charbel-j-estephan/Fm_Stereo_Encoder_Decoder/Decoder/preview_bottom.png

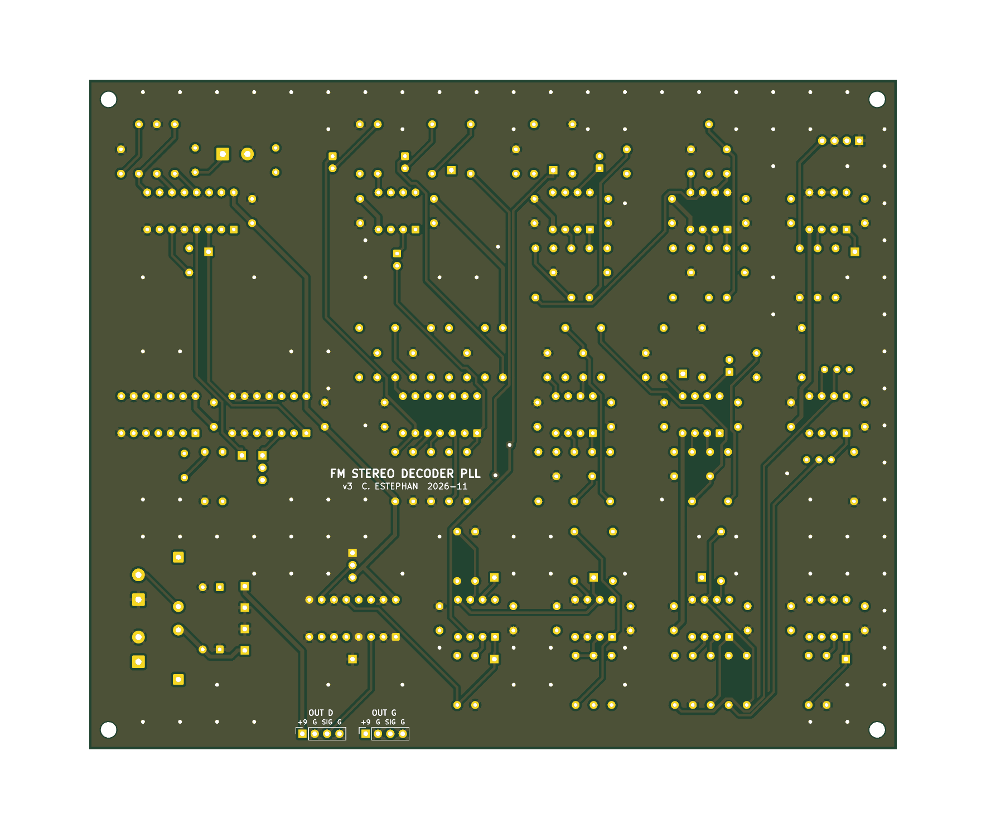
Decoder/preview_bottom.png
