charbel-j-estephan/Fm_Stereo_Encoder_Decoder/Decoder/preview_top.png

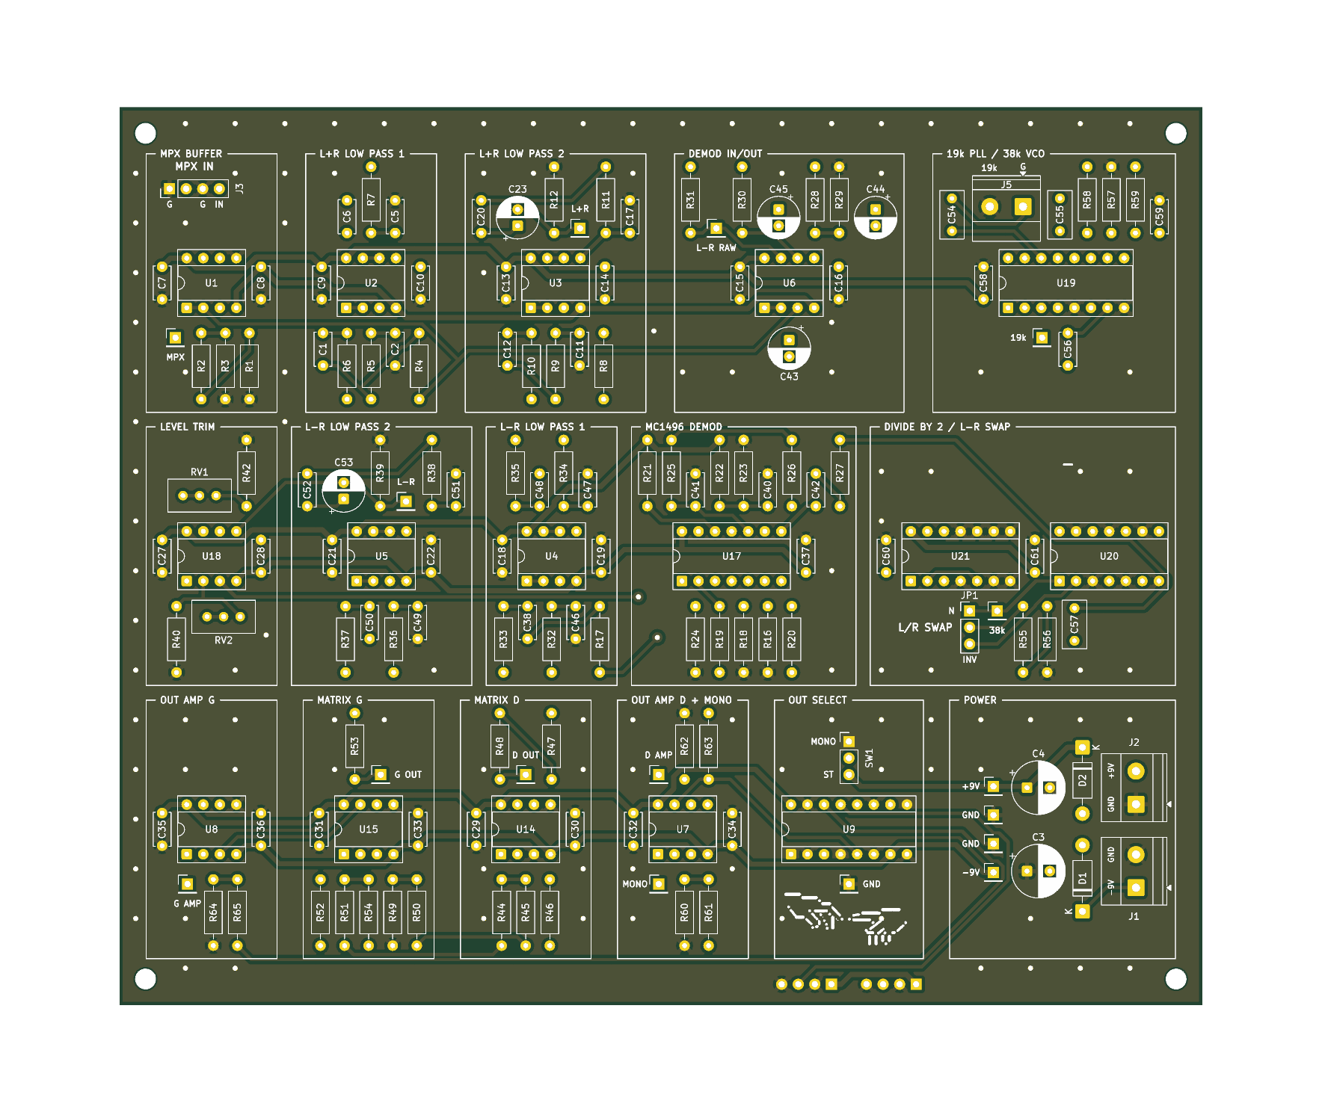
Decoder/preview_top.png
