charbel-j-estephan/Fm_Stereo_Encoder_Decoder/Encoder/FM_Encoder_Buy_List.xlsx

Sheet: Buy list
Group | Part | Refs | Qty needed | Qty to buy | Unit price USD | Line total USD | EKT item | Link | Notes
ICs | CD4046 PLL | U11 | 1 | 2 | $0.60 |  | 149 | https://ekt1.com/en/item/149
ICs | CD4013 dual D flip flop | U12 | 1 | 2 | $0.50 |  | 136 | https://ekt1.com/en/item/136
ICs | CD4069 hex inverter | U13 | 1 | 2 | $0.50 |  | 157 | https://ekt1.com/en/item/157
ICs | TL072 dual op amp | U1 U3 U4 U5 U6 U8 | 6 | 7 | $0.60 |  | 1492 | https://ekt1.com/en/item/1492
ICs | NE5532P dual op amp | U2 U10 | 2 | 3 | $0.50 |  | 4489 | https://ekt1.com/en/item/4489
ICs | MC1496 balanced modulator | U9 | 1 | 2 | $1.75 |  | 6175 | https://ekt1.com/en/item/6175
Sockets | DIP 8 socket | U1 U2 U3 U4 U5 U6 U8 U10 | 8 | 9 | $0.08 |  | 1973 | https://ekt1.com/en/item/1973
Sockets | DIP 14 socket | U9 U12 U13 | 3 | 4 | $0.10 |  | 1975 | https://ekt1.com/en/item/1975
Sockets | DIP 16 socket | U11 | 1 | 2 | $0.10 |  | 1974 | https://ekt1.com/en/item/1974
Diodes | 1N5819 Schottky | D1 D2 | 2 | 3 | $0.15 |  | 7983 | https://ekt1.com/en/item/7983
Diodes | 1N4148 | D3 D4 D5 D6 | 4 | 6 | $0.05 |  | 2520 | https://ekt1.com/en/item/2520
Resistors | 51R 0.25W | R31 R32 | 2 | 4 | $0.01 |  | 6386 | https://ekt1.com/en/item/6386
Resistors | 1K 0.5W substitute | R29 R35 R37 | 3 | 5 | $0.02 |  | 2435 | https://ekt1.com/en/item/2435 | 0.25W 1K (item 6409) is out of stock
Resistors | 1K5 0.25W | R55 | 1 | 3 | $0.01 |  | 6398 | https://ekt1.com/en/item/6398
Resistors | 1K8 0.25W | R7 R8 | 2 | 4 | $0.01 |  | 6369 | https://ekt1.com/en/item/6369
Resistors | 2K2 0.25W | R42 (and R1 R5 if you accept 2K2) | 1 | 3 | $0.01 |  | 6411 | https://ekt1.com/en/item/6411 | EKT has no 2K4. See next row
Resistors | 2K4 0.25W | R1 R5 | 2 | 0 |  |  |  |  | Not on EKT. Use 2K2 or ask EKT. Check gain change first
Resistors | 3K3 0.25W | R16 R18 | 2 | 4 | $0.01 |  | 6412 | https://ekt1.com/en/item/6412
Resistors | 3K9 0.25W | R34 R36 | 2 | 4 | $0.01 |  | 6413 | https://ekt1.com/en/item/6413
Resistors | 4K7 0.25W | R53 | 1 | 3 | $0.01 |  | 6394 | https://ekt1.com/en/item/6394
Resistors | 6K8 0.25W | R33 | 1 | 3 | $0.01 |  | 6414 | https://ekt1.com/en/item/6414
Resistors | 7K5 0.25W | R41 | 1 | 3 | $0.01 |  | 6418 | https://ekt1.com/en/item/6418
Resistors | 8K2 0.25W | R54 | 1 | 3 | $0.01 |  | 6375 | https://ekt1.com/en/item/6375
Resistors | 10K 0.25W | R2 R3 R9 R10 R11 R12 R38 R52 | 8 | 10 | $0.01 |  | 6410 | https://ekt1.com/en/item/6410
Resistors | 12K 0.25W | R13 R14 R15 R17 R51 | 5 | 7 | $0.01 |  | 6422 | https://ekt1.com/en/item/6422 | R51 sets the VCO range
Resistors | 15K 0.25W | R39 R40 R43 R44 | 4 | 6 | $0.01 |  | 6423 | https://ekt1.com/en/item/6423
Resistors | 100K 0.25W | R4 R6 R19 R20 R21 R22 R23 R24 R25 R26 R27 R28 R30 R45 R48 R49 R50 | 17 | 20 | $0.01 |  | 6425 | https://ekt1.com/en/item/6425
Resistors | 270K 0.25W | R46 | 1 | 3 | $0.01 |  | 6353 | https://ekt1.com/en/item/6353
Resistors | 330K 0.25W | R47 in series with 30K | 1 | 3 | $0.01 |  | 6352 | https://ekt1.com/en/item/6352 | 330K plus 30K makes 360K
Resistors | 30K 0.25W | R47 in series with 330K | 1 | 3 | $0.01 |  | 211576 | https://ekt1.com/en/item/211576 | EKT has no 360K
Capacitors | 100n multilayer ceramic 50V | C7 C8 C9 C10 C13 C14 C15 C16 C18 C19 C21 C22 C27 C28 C29 C30 C37 C38 C39 C40 C41 C42 C43 C44 C48 C50 C51 C52 | 28 | 34 | $0.10 |  | 218477 | https://ekt1.com/en/item/218477
Capacitors | 1n multilayer ceramic 50V | C5 C20 C23 C24 C25 C26 C47 | 7 | 9 | $0.10 |  | 218480 | https://ekt1.com/en/item/218480 | Also use 1 for C6 with 220p
Capacitors | 2.2n ceramic 50V | C17 C32 C34 | 3 | 5 | $0.10 |  | 1965 | https://ekt1.com/en/item/1965
Capacitors | 3.3n ceramic 50V | C35 | 1 | 3 | $0.10 |  | 1966 | https://ekt1.com/en/item/1966
Capacitors | 330p ceramic 50V | C31 C33 | 2 | 4 | $0.10 |  | 1950 | https://ekt1.com/en/item/1950
Capacitors | 220p ceramic 50V | C36 and C6 in parallel with 1n | 1 | 3 | $0.10 |  | 1949 | https://ekt1.com/en/item/1949 | EKT has no 1.2n. 1n plus 220p makes 1.22n for C6
Capacitors | 100p ceramic 50V | C11 C12 | 2 | 4 | $0.10 |  | 1948 | https://ekt1.com/en/item/1948 | Footprint is small. Multilayer 100p (item 218478) may fit better
Capacitors | 1u film 105 100V | C1 C2 C45 C46 C49 | 5 | 7 | $0.20 |  | 2182 | https://ekt1.com/en/item/2182 | Measure first. Footprint is 7.2 by 3.5 mm, 5 mm pitch
Capacitors | 22u 25V electrolytic | C3 C4 | 2 | 3 | $0.10 |  | 2103 | https://ekt1.com/en/item/2103 | 13x5 mm part. Footprint is 8 mm wide, 3.5 mm pitch
Connectors | Screw terminal 5.08 mm 2 pin | J1 J2 J5 | 3 | 4 | $0.08 |  | 6530 | https://ekt1.com/en/item/6530 | J5 is the 19 kHz input
Connectors | Female header strip 10x1 | J3 J4 (2 pieces of 4 pins) | 2 | 2 | $0.30 |  | 8332 | https://ekt1.com/en/item/8332 | Skip if you use the jack modules
Connectors | Male header strip 40x1 | JP1 (3 pins) and 35 test points (TP) as single pins | 38 | 2 | $0.20 |  | 8331 | https://ekt1.com/en/item/8331 | 38 pins in total. Buy 2 strips so you have spares. Dynamic Solutions sells the same strip at 0.20
Connectors | BNC female screw junction | J5 input (one per board) | 1 | 4 | $0.60 |  | 426959 | https://ekt1.com/en/item/426959 | Center screw to J5 pin 1, shield screw to J5 pin 2. Ask EKT for 4 with Ask for quantity
Connectors | Audio Module Jack 3.5mm | J3 J4 modules | 4 | 5 | $0.87 |  |  |  | Not found on ekt1.com. Wakilni link in the Notes sheet. Ask EKT
Connectors | Jumper shunt 2.54 mm 2 pin | JP1 | 1 | 2 | $0.10 |  | 214104 | https://ekt1.com/en/item/214104 | Found on ekt1.com
 |  |  |  |  | Total before VAT

Sheet: Notes
Prices come from ekt1.com in October 2026 and exclude VAT.
Yellow rows are not sold on ekt1.com. Ask EKT or use the substitute.
Wakilni jack module link https://shop.wakilni.com/product/audio-module-jack-3-5mm-connector/ at $0.87. The page says EKT Katrangi Bros sells it.
Quantities needed come from the Encoder_gen schematic netlist. Buy quantities add spares.
J5 is a 2 pin screw terminal. Glue the BNC screw junction to a base plate or bracket and wire it to J5 with short twisted wires.
Test points are single 2.54 mm male header pins broken off the strip. The board has four 3.2 mm corner holes for M3 screws.
Check the 1u film, 22u electrolytic and 100p sizes against the board footprints before you pay.
