charbel-j-estephan/Fm_Stereo_Encoder_Decoder/Decoder/Receiver schematic.pdf

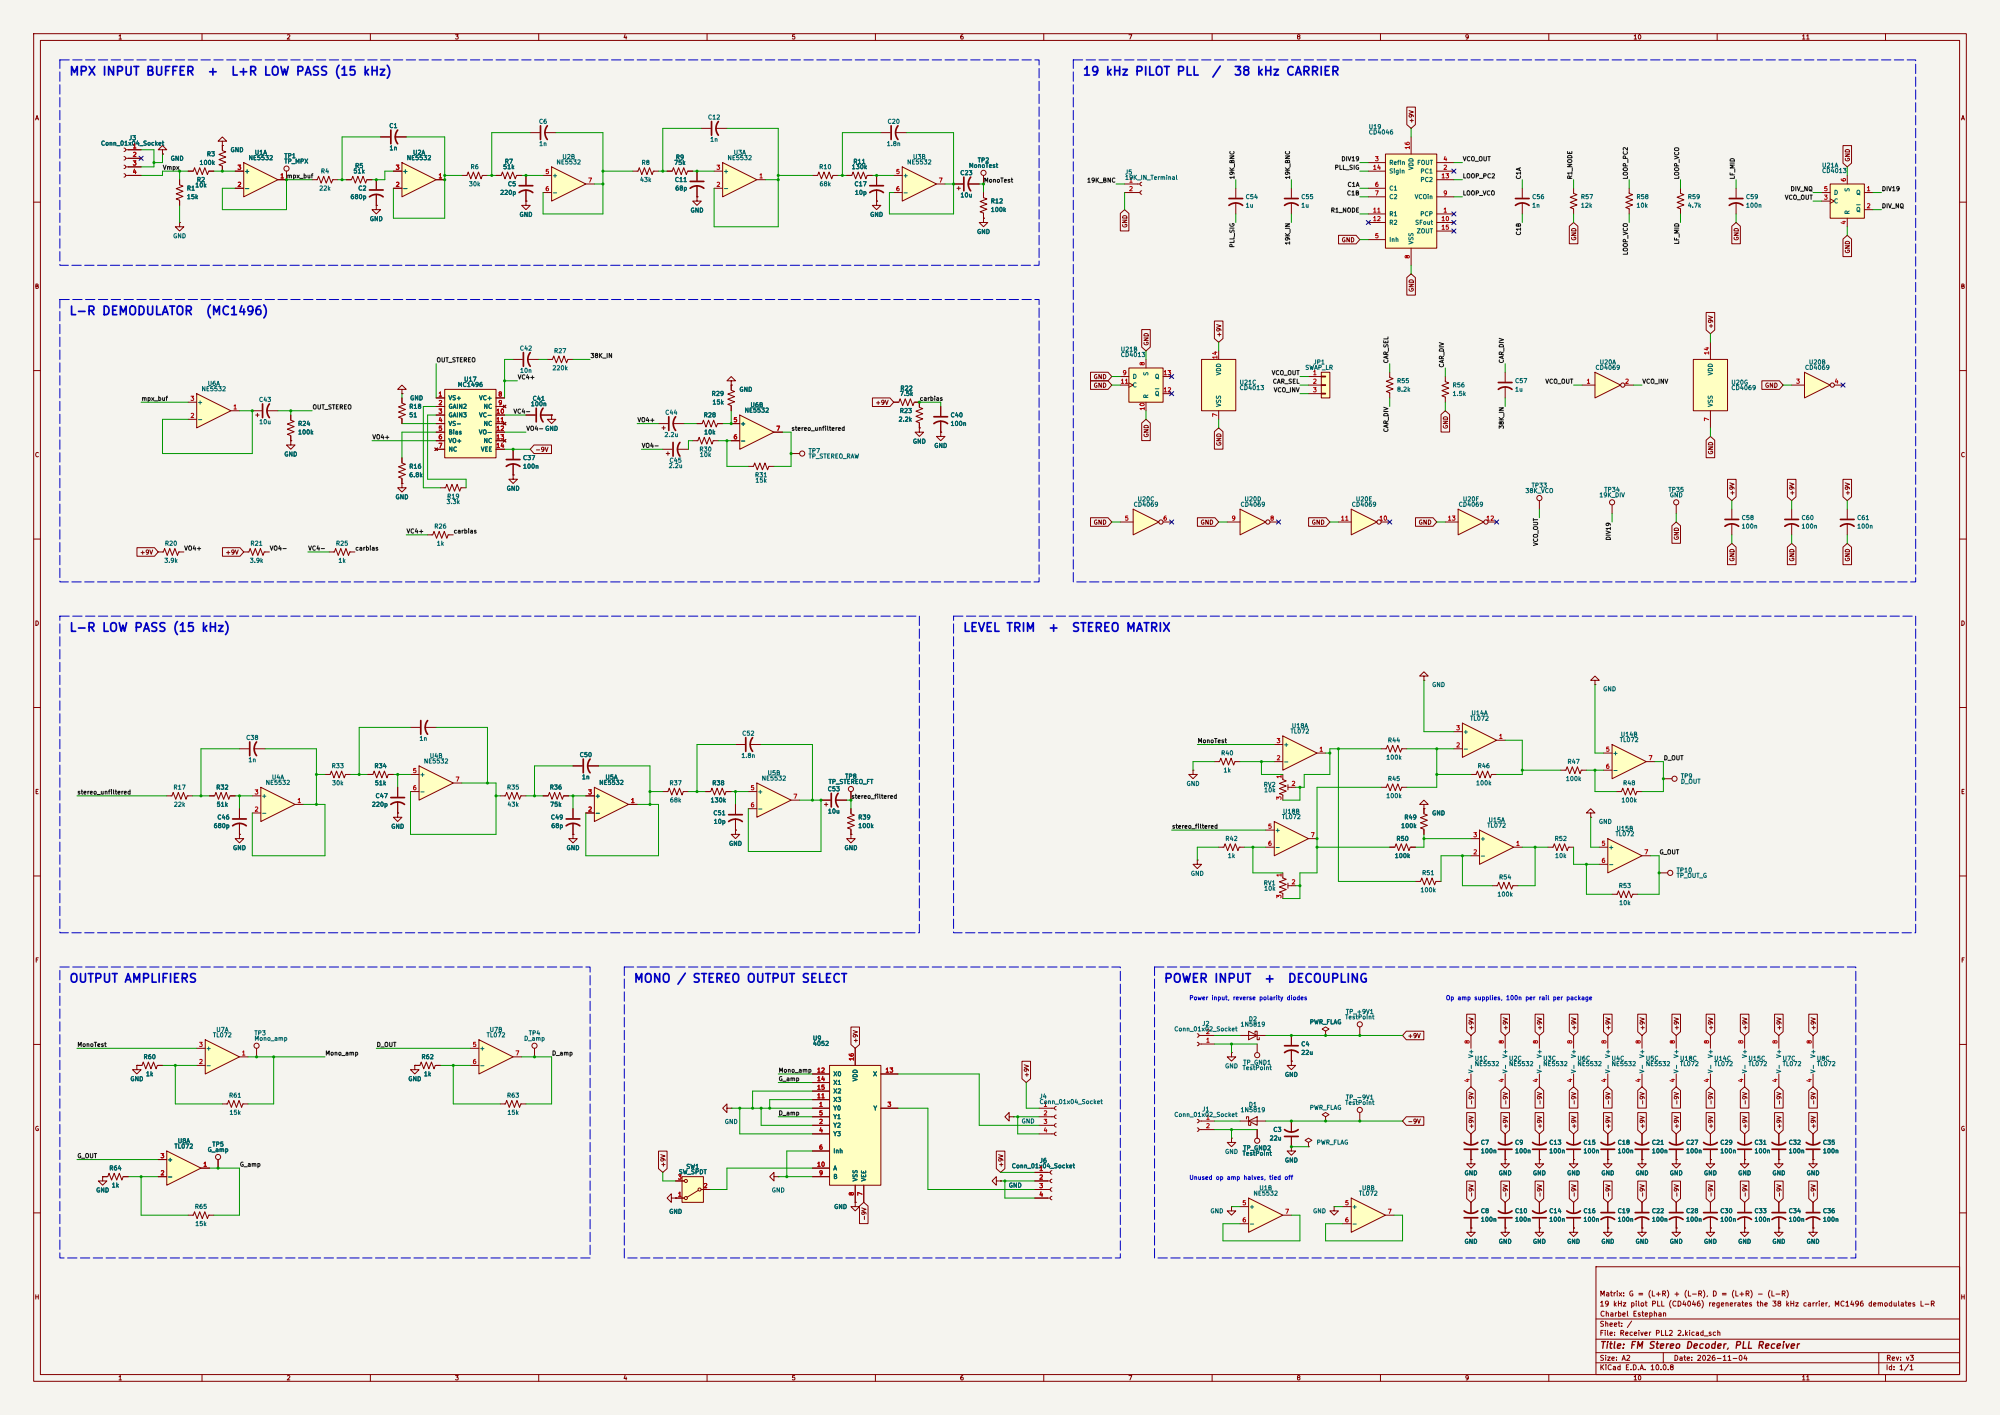
[picture p4: page 1]

Power input, reverse polarity diodes L-R LOW PASS (15 kHz)

LEVEL TRIM + STEREO MATRIX

MONO / STEREO OUTPUT SELECT

Op amp supplies, 100n per rail per package

Matrix: G = (L+R) + (L-R), D = (L+R) - (L-R)
19 kHz pilot PLL (CD4046) regenerates the 38 kHz carrier, MC1496 demodulates L-R
Charbel Estephan
Sheet: /
File: Receiver PLL2 2.kicad_sch
Title: FM Stereo Decoder, PLL Receiver

Size: A2 | Rev: v3
KiCad E.D.A. 10.0.8 | Id: 1/1
