charbel-j-estephan/Fm_Stereo_Encoder_Decoder/Encoder/Encoder_Schematic_color.pdf

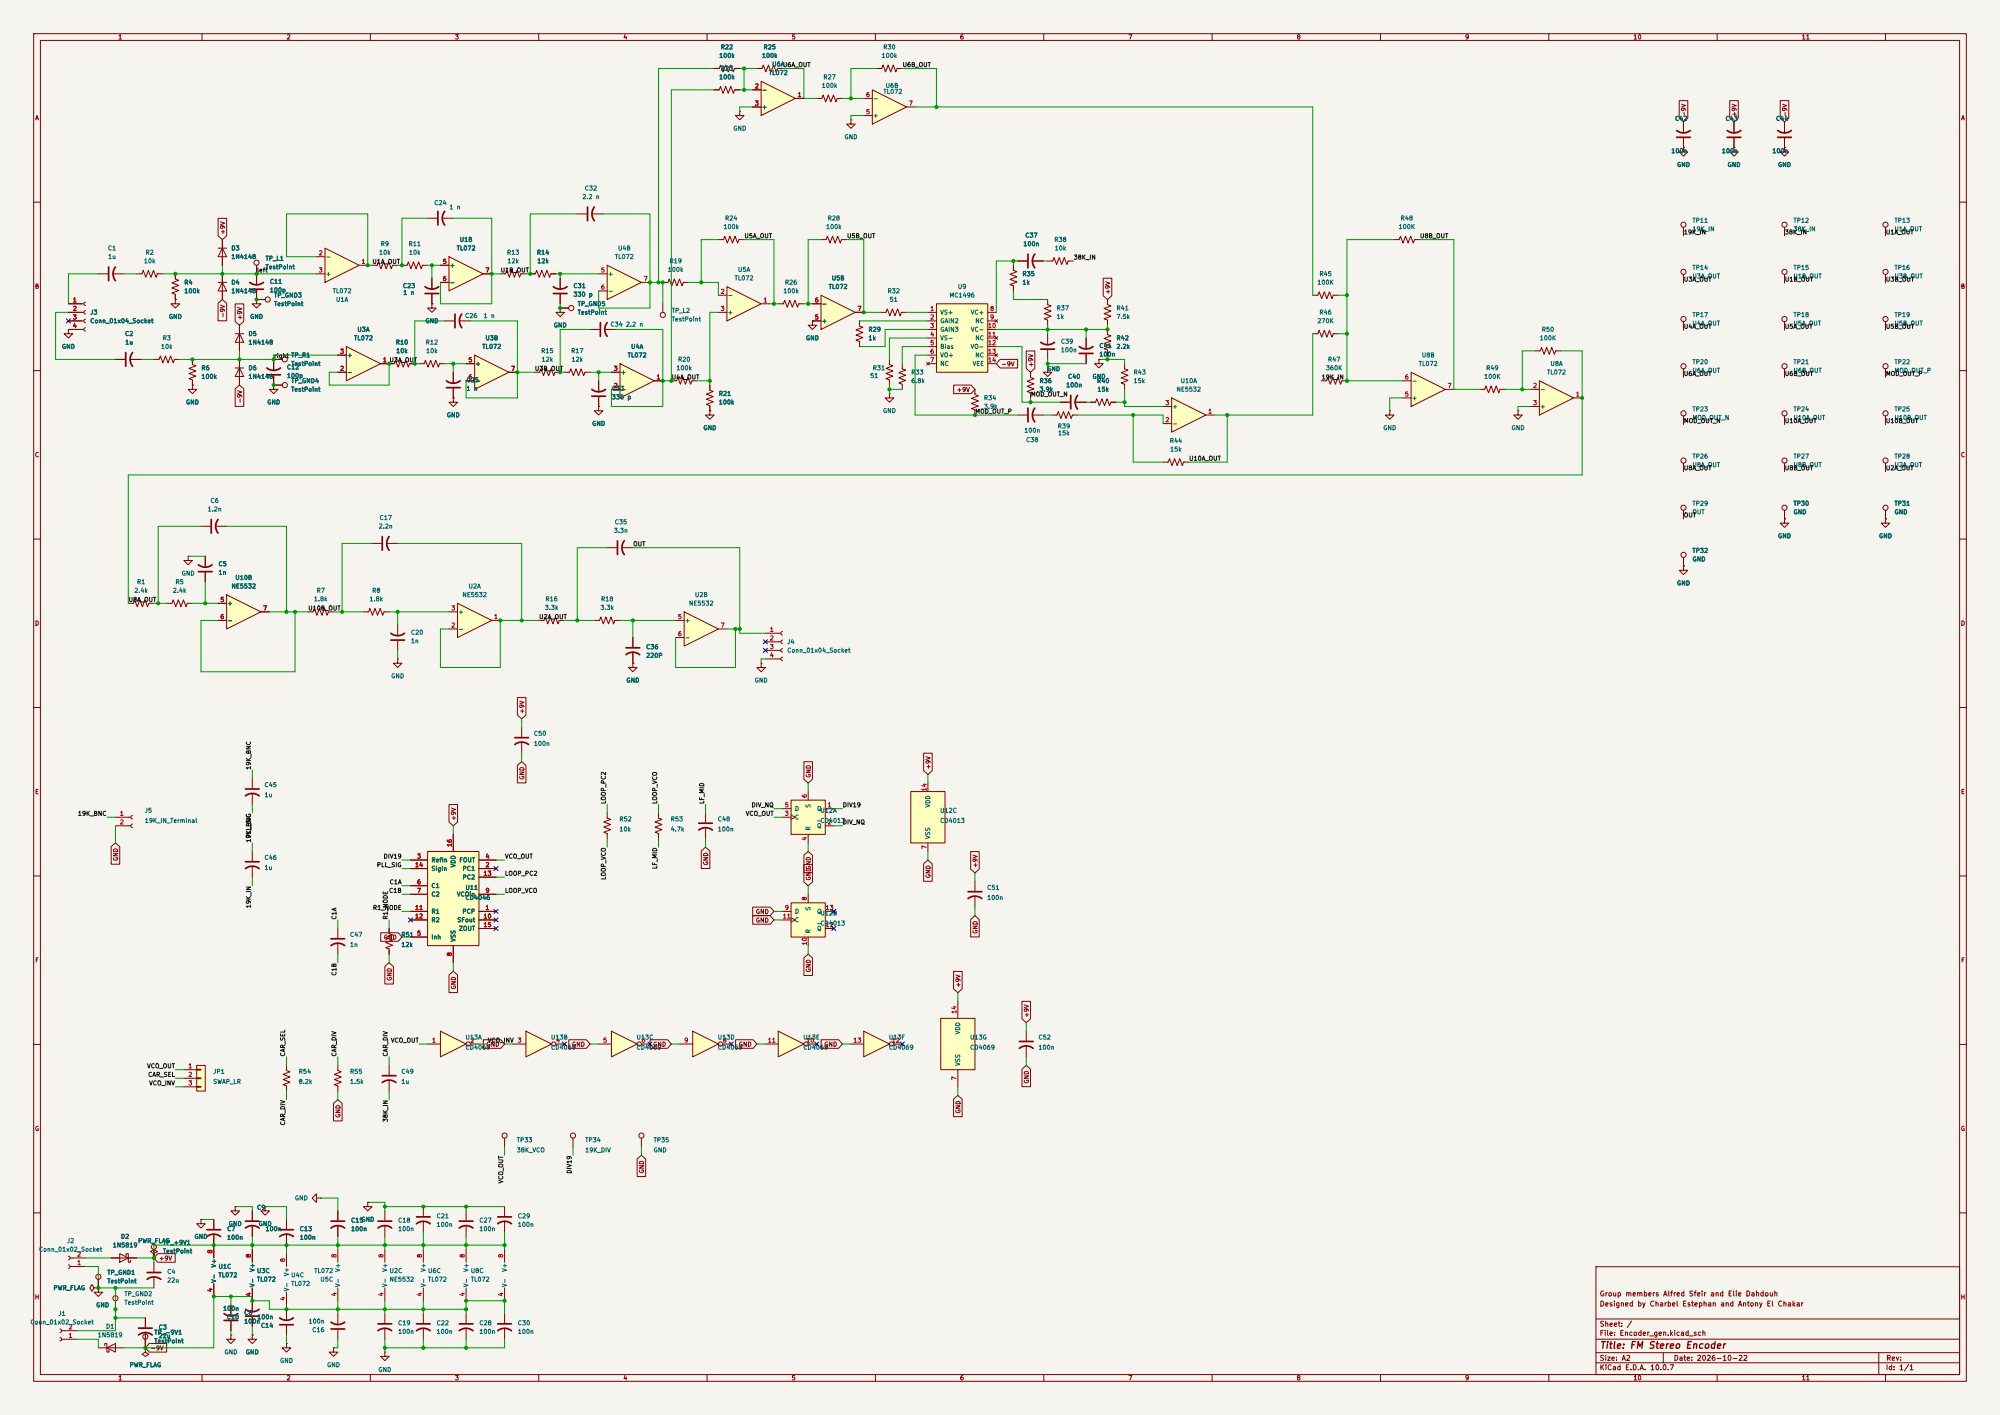
[picture p5: page 1]

Group members Alfred Sfeir and Elie Dahdouh
Designed by Charbel Estephan and Antony El Chakar

Sheet: /
File: Encoder_gen.kicad_sch
Title: FM Stereo Encoder

Size: A2 | Rev:
KiCad E.D.A. 10.0.7 | Id: 1/1
