charbel-j-estephan/Fm_Stereo_Encoder_Decoder/Encoder/Encoder_PCB_top_1to1_color.pdf

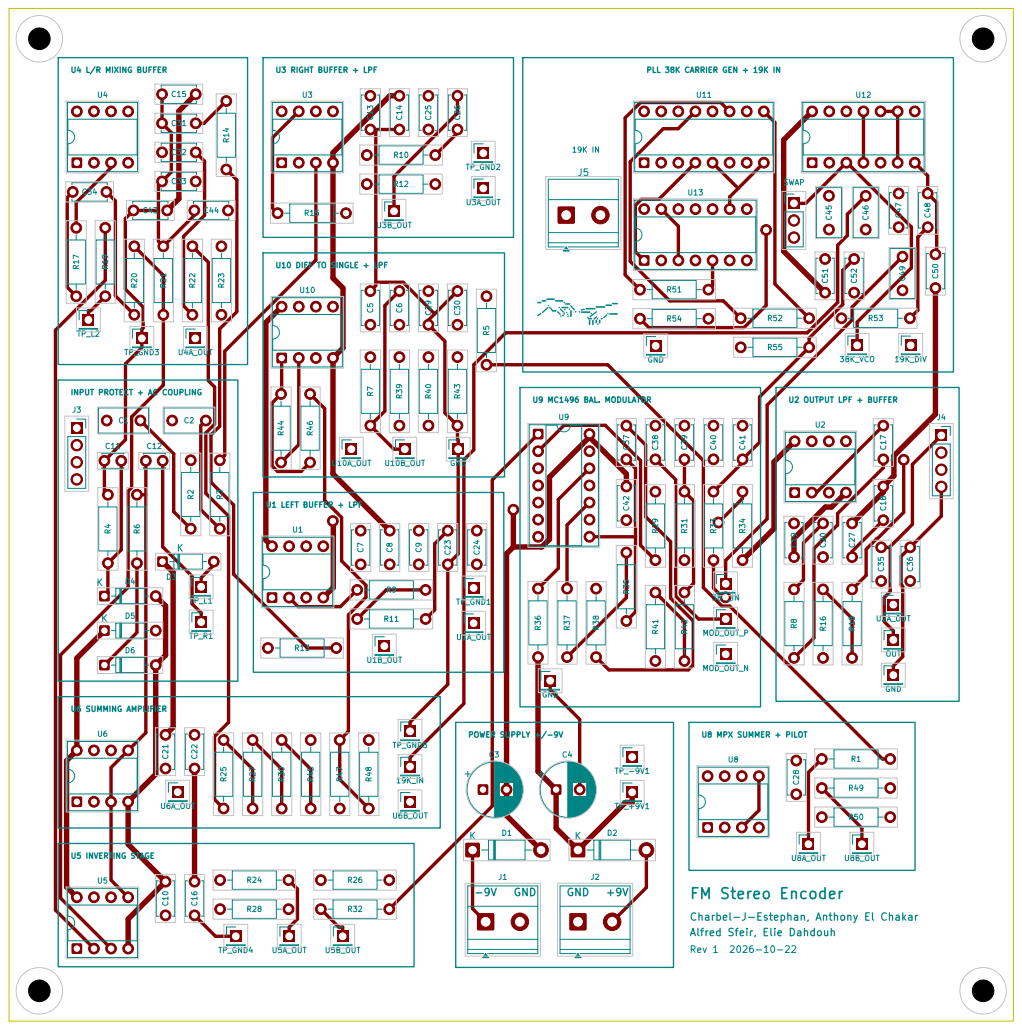
[picture p6: page 1]

PLL 38K CARRIER GEN + 19K IN
