charbel-j-estephan/Fm_Stereo_Encoder_Decoder/Decoder/Receiver.kicad_pcb

## KiCad design Decoder/Receiver.kicad_pcb (2026-11-05)

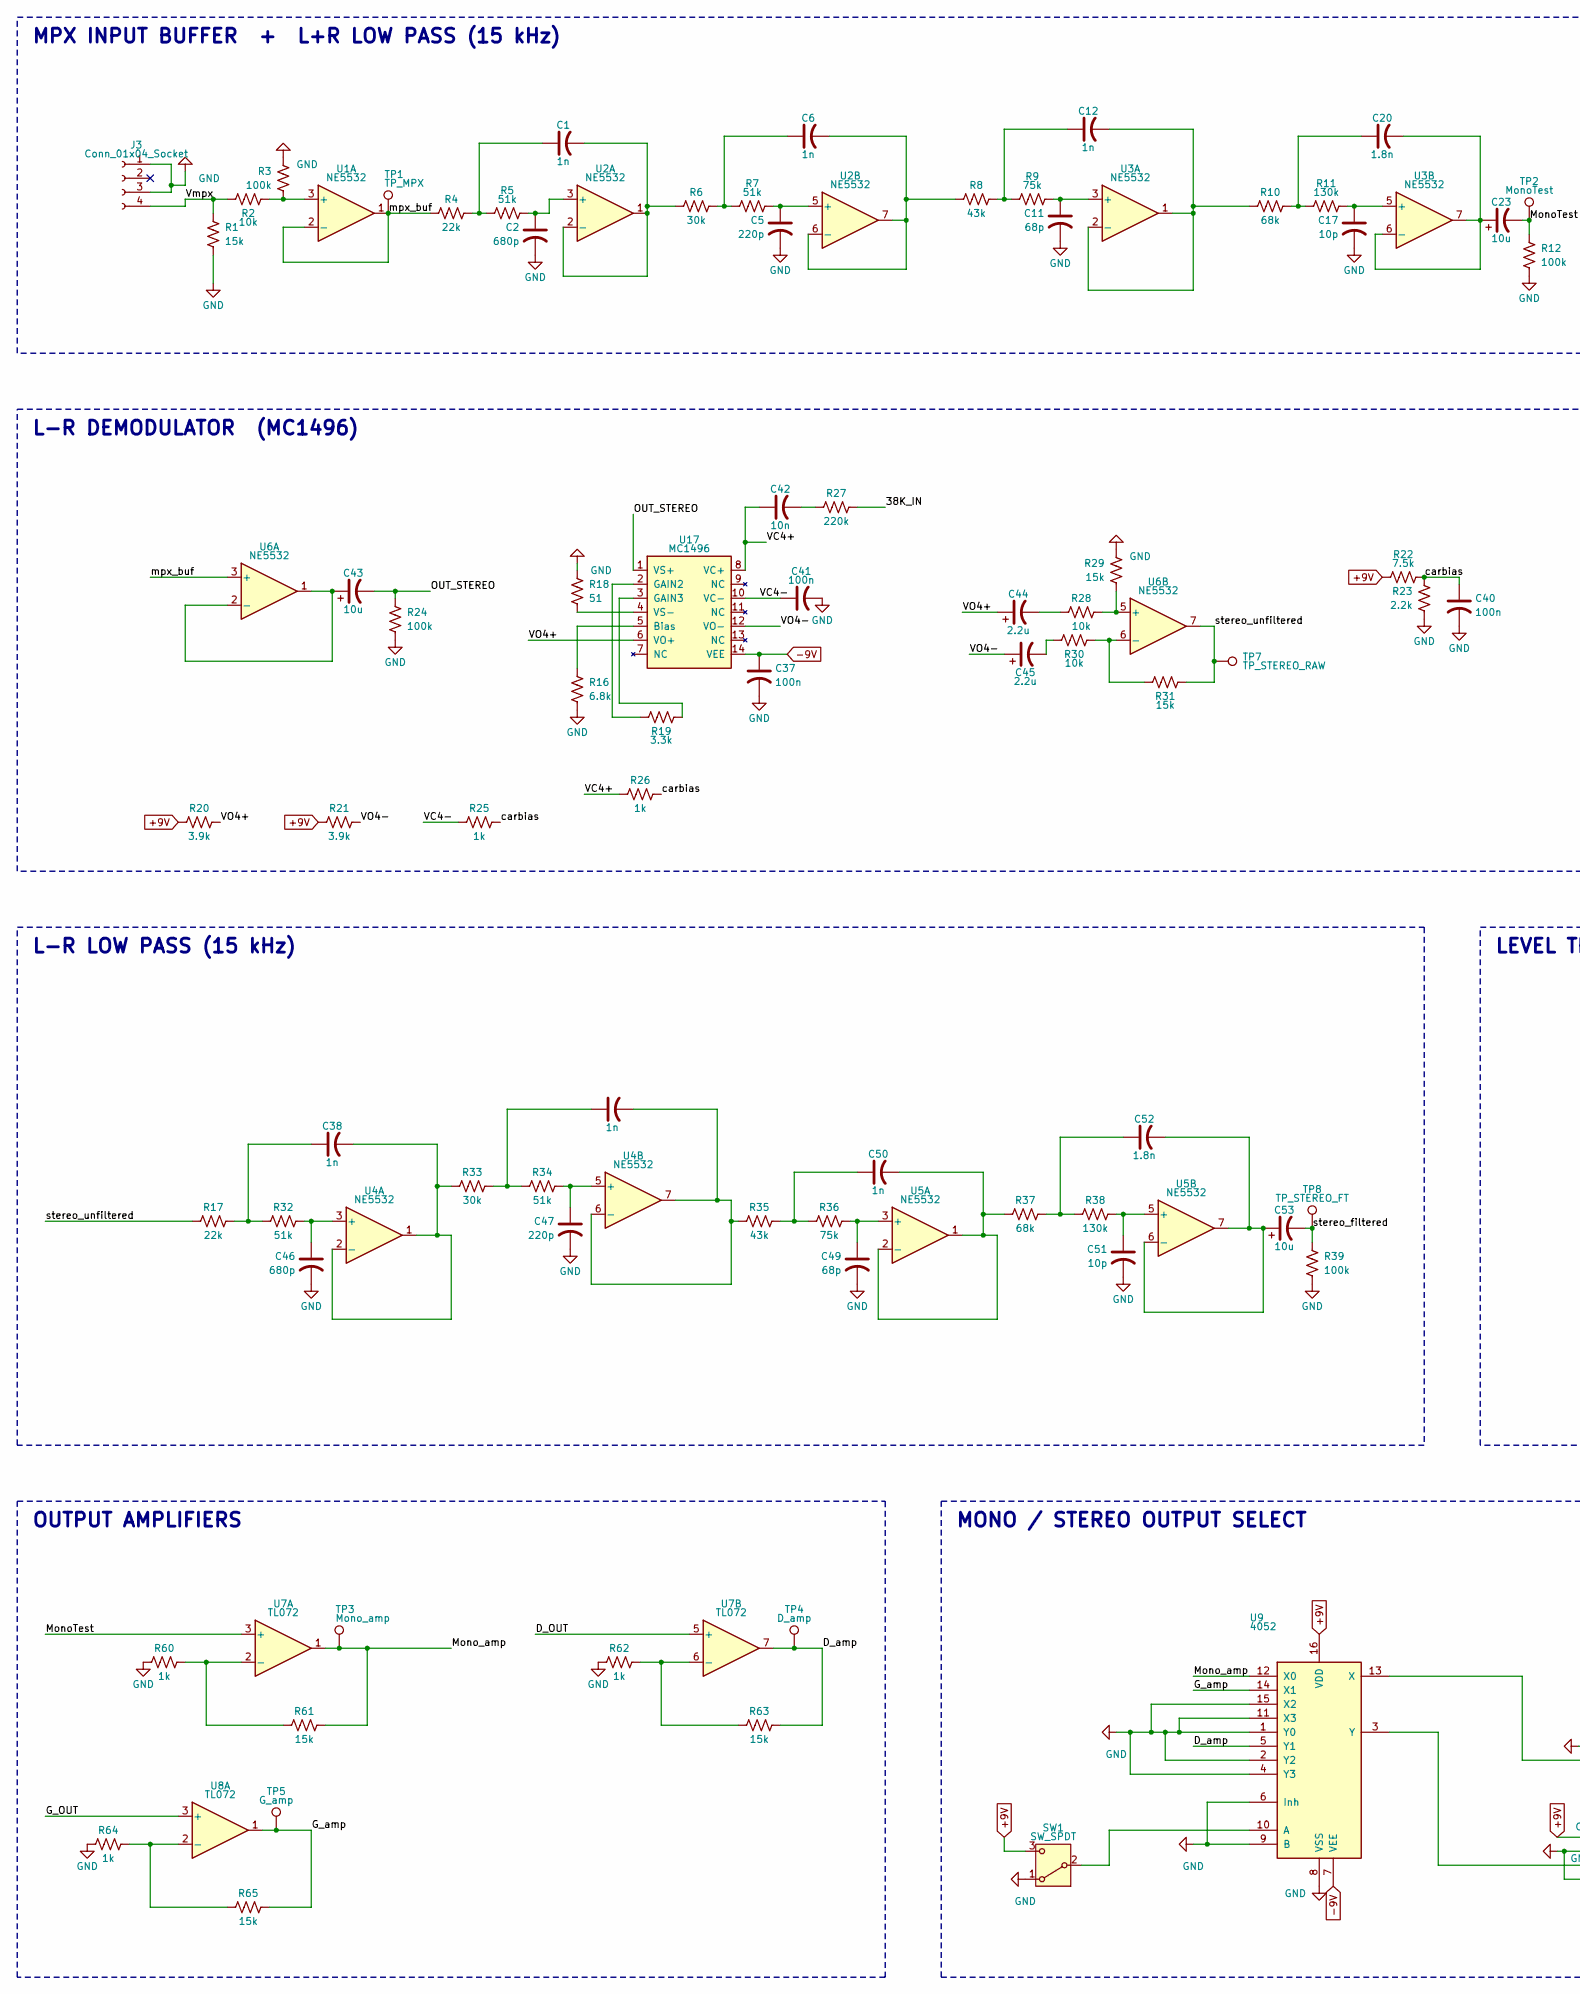
[picture p7: schematic Receiver.kicad_sch, FM Stereo Decoder, PLL Receiver, part in row 1, column 1]

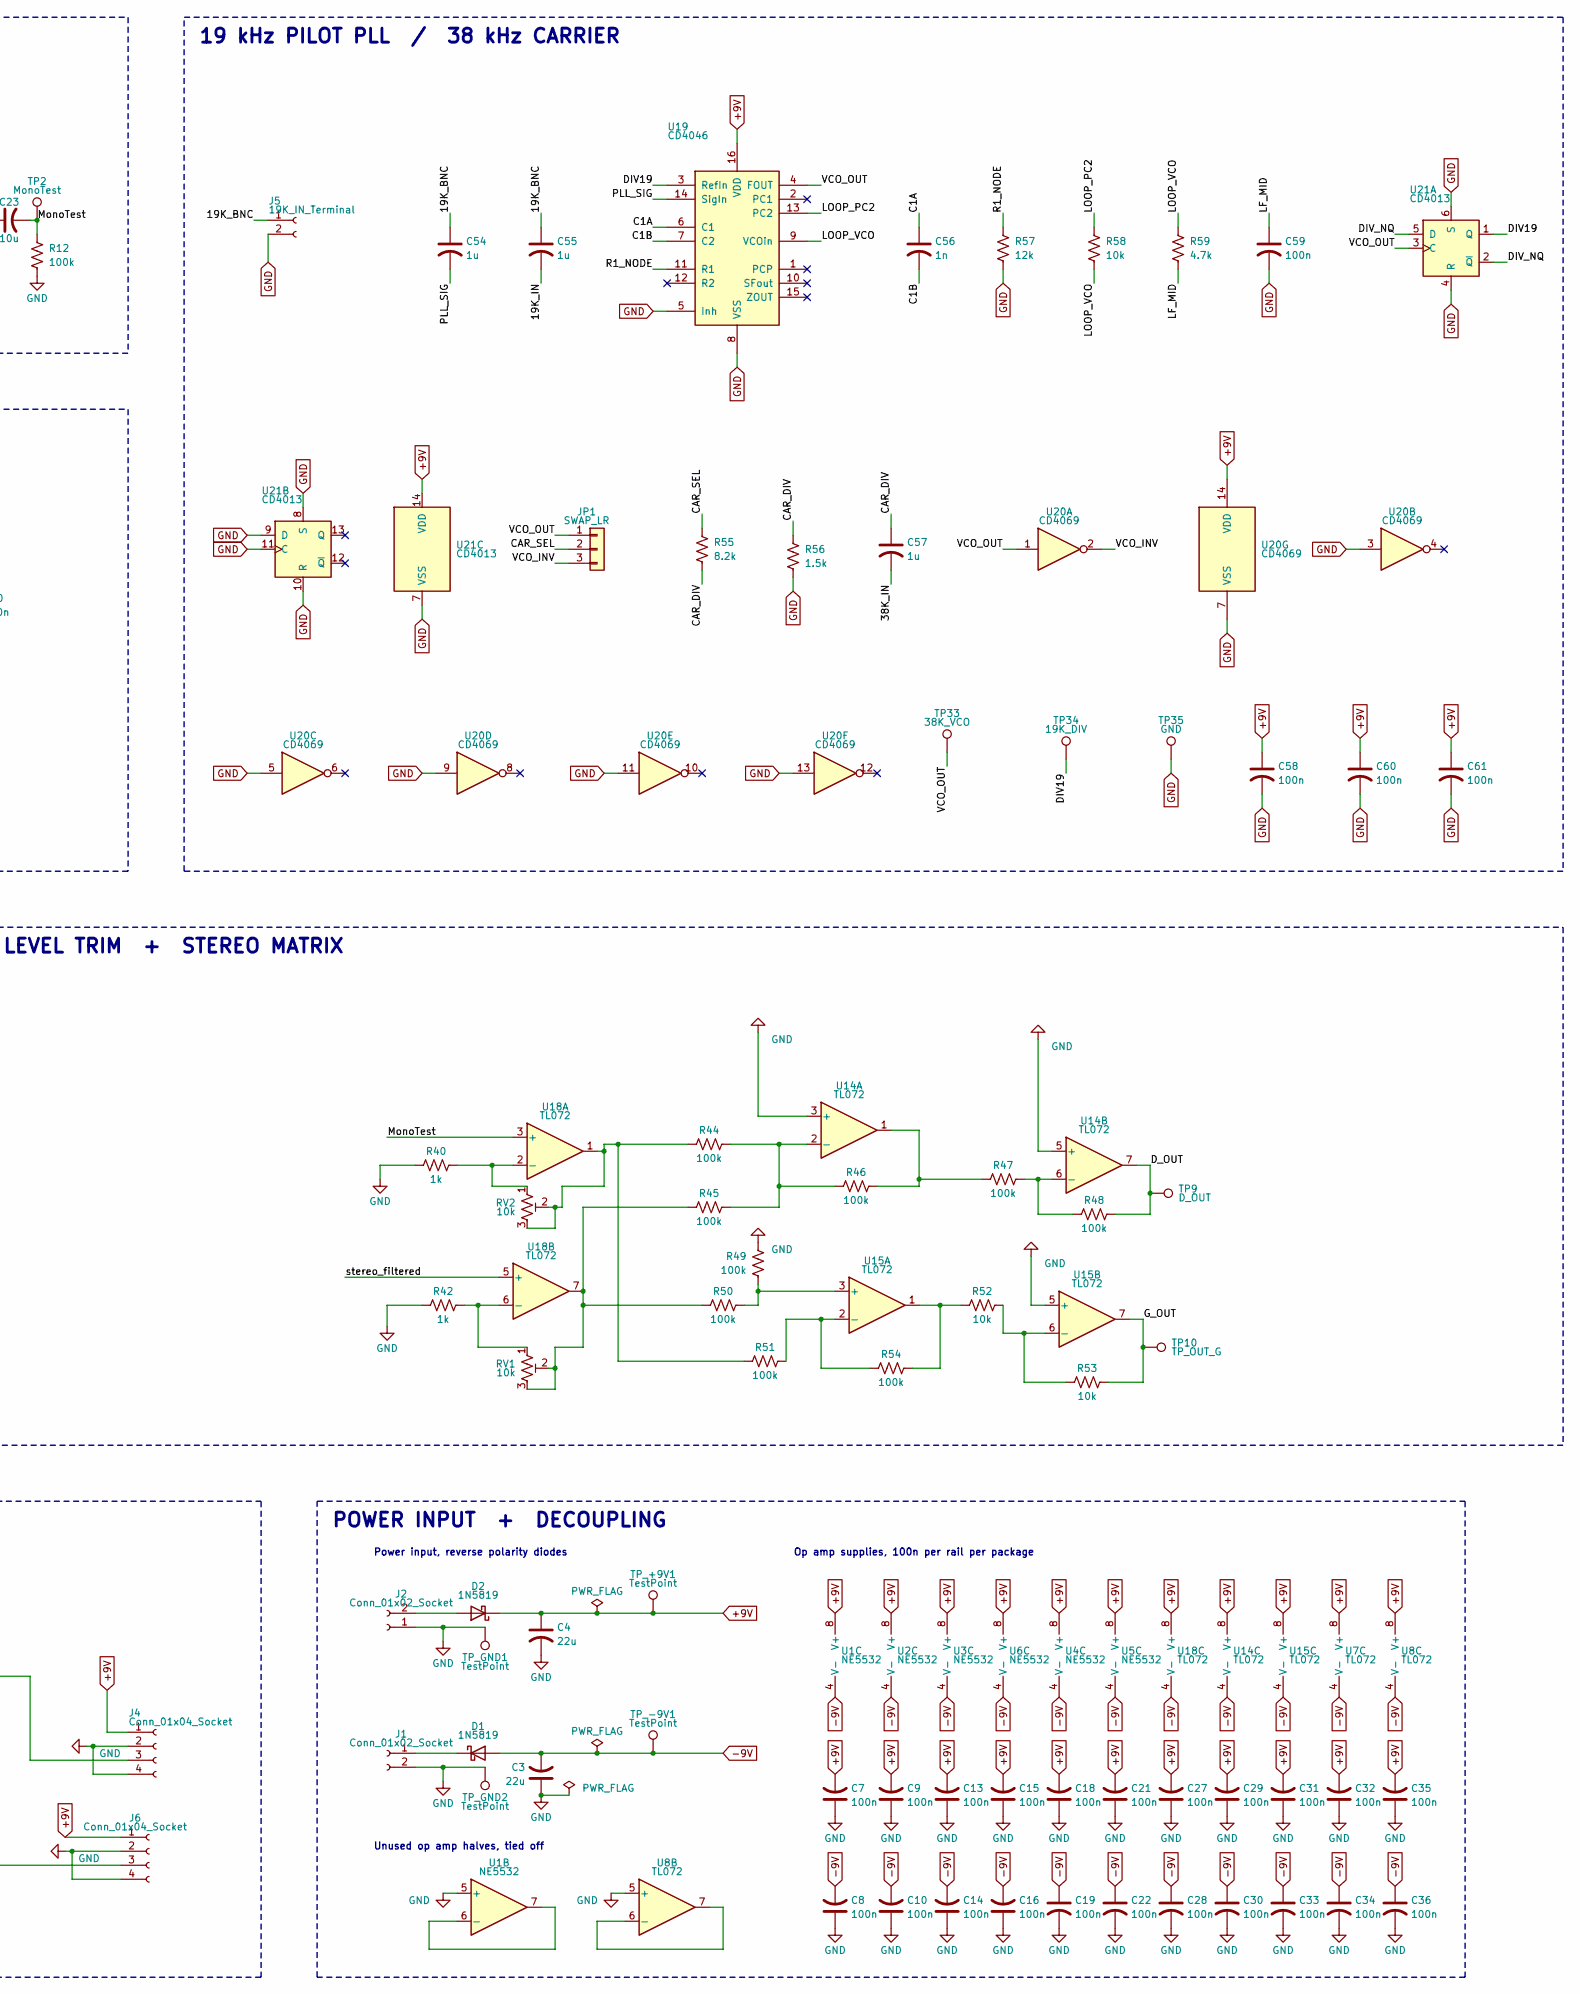
[picture p8: schematic Receiver.kicad_sch, FM Stereo Decoder, PLL Receiver, part in row 1, column 2]

Parts:
C1, C6, C12, C38, C48, C50, C56: 1n; C_Disc_D5.0mm_W2.5mm_P5.00mm
C2, C46: 680p; C_Disc_D5.0mm_W2.5mm_P5.00mm
C3, C4: 22u; CP_Radial_D8.0mm_P3.50mm
C5, C47: 220p; C_Disc_D5.0mm_W2.5mm_P5.00mm
C7, C8, C9, C10, C13, C14, C15, C16, C18, C19, C21, C22, C27, C28, C29, C30, C31, C32, C33, C34, C35, C36, C37, C40, C41, C58, C59, C60, C61: 100n; C_Disc_D5.0mm_W2.5mm_P5.00mm
C11, C49: 68p; C_Disc_D5.0mm_W2.5mm_P5.00mm
C17, C51: 10p; C_Disc_D5.0mm_W2.5mm_P5.00mm
C20, C52: 1.8n; C_Disc_D5.0mm_W2.5mm_P5.00mm
C23, C43, C53: 10u; CP_Radial_D6.3mm_P2.50mm
C42: 10n; C_Disc_D5.0mm_W2.5mm_P5.00mm
C44, C45: 2.2u; CP_Radial_D6.3mm_P2.50mm
C54, C55, C57: 1u; C_Rect_L7.2mm_W3.5mm_P5.00mm
D1, D2: 1N5819; D_DO-41_SOD81_P10.16mm_Horizontal
J1, J2: Conn_01x02_Socket; TerminalBlock_Phoenix_MKDS-1,5-2-5.08_1x02_P5.08mm_Horizont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
J3: Conn_01x04_Socket; PinHeader_1x04_P2.54mm_Vertical
J4, J6: Conn_01x04_Socket; PinSocket_1x04_P2.54mm_Vertical
J5: 19K_IN_Terminal; TerminalBlock_Phoenix_MKDS-1,5-2-5.08_1x02_P5.08mm_Horizont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
JP1: SWAP_LR; PinHeader_1x03_P2.54mm_Vertical
R1, R29, R31, R61, R63, R65: 15k; R_Axial_DIN0207_L6.3mm_D2.5mm_P10.16mm_Horizontal
R2, R28, R30, R52, R53, R58: 10k; R_Axial_DIN0207_L6.3mm_D2.5mm_P10.16mm_Horizontal
R3, R12, R24, R39, R44, R45, R46, R47, R48, R49, R50, R51, R54: 100k; R_Axial_DIN0207_L6.3mm_D2.5mm_P10.16mm_Horizontal
R4, R17: 22k; R_Axial_DIN0207_L6.3mm_D2.5mm_P10.16mm_Horizontal
R5, R7, R32, R34: 51k; R_Axial_DIN0207_L6.3mm_D2.5mm_P10.16mm_Horizontal
R6, R33: 30k; R_Axial_DIN0207_L6.3mm_D2.5mm_P10.16mm_Horizontal
R8, R35: 43k; R_Axial_DIN0207_L6.3mm_D2.5mm_P10.16mm_Horizontal
R9, R36: 75k; R_Axial_DIN0207_L6.3mm_D2.5mm_P10.16mm_Horizontal
R10, R37: 68k; R_Axial_DIN0207_L6.3mm_D2.5mm_P10.16mm_Horizontal
R11, R38: 130k; R_Axial_DIN0207_L6.3mm_D2.5mm_P10.16mm_Horizontal
R16: 6.8k; R_Axial_DIN0207_L6.3mm_D2.5mm_P10.16mm_Horizontal
R18: 51; R_Axial_DIN0207_L6.3mm_D2.5mm_P10.16mm_Horizontal
R19: 3.3k; R_Axial_DIN0207_L6.3mm_D2.5mm_P10.16mm_Horizontal
R20, R21: 3.9k; R_Axial_DIN0207_L6.3mm_D2.5mm_P10.16mm_Horizontal
R22: 7.5k; R_Axial_DIN0207_L6.3mm_D2.5mm_P10.16mm_Horizontal
R23: 2.2k; R_Axial_DIN0207_L6.3mm_D2.5mm_P10.16mm_Horizontal
R25, R26, R40, R42, R60, R62, R64: 1k; R_Axial_DIN0207_L6.3mm_D2.5mm_P10.16mm_Horizontal
R27: 220k; R_Axial_DIN0207_L6.3mm_D2.5mm_P10.16mm_Horizontal
R55: 8.2k; R_Axial_DIN0207_L6.3mm_D2.5mm_P10.16mm_Horizontal
R56: 1.5k; R_Axial_DIN0207_L6.3mm_D2.5mm_P10.16mm_Horizontal
R57: 12k; R_Axial_DIN0207_L6.3mm_D2.5mm_P10.16mm_Horizontal
R59: 4.7k; R_Axial_DIN0207_L6.3mm_D2.5mm_P10.16mm_Horizontal
RV1, RV2: 10k; Potentiometer_Bourns_3296W_Vertical
SW1: SW_SPDT; PinHeader_1x03_P2.54mm_Vertical
TP1: TP_MPX; PinHeader_1x01_P2.54mm_Vertical
TP2: MonoTest; PinHeader_1x01_P2.54mm_Vertical
TP3: Mono_amp; PinHeader_1x01_P2.54mm_Vertical
TP4: D_amp; PinHeader_1x01_P2.54mm_Vertical
TP5: G_amp; PinHeader_1x01_P2.54mm_Vertical
TP7: TP_STEREO_RAW; PinHeader_1x01_P2.54mm_Vertical
TP8: TP_STEREO_FT; PinHeader_1x01_P2.54mm_Vertical
TP9: D_OUT; PinHeader_1x01_P2.54mm_Vertical
TP10: TP_OUT_G; PinHeader_1x01_P2.54mm_Vertical
TP33: 38K_VCO; PinHeader_1x01_P2.54mm_Vertical
TP34: 19K_DIV; PinHeader_1x01_P2.54mm_Vertical
TP35: GND; PinHeader_1x01_P2.54mm_Vertical
TP_+9V1: TestPoint; PinHeader_1x01_P2.54mm_Vertical
TP_-9V1: TestPoint; PinHeader_1x01_P2.54mm_Vertical
TP_GND1, TP_GND2: TestPoint; PinHeader_1x01_P2.54mm_Vertical
U1, U2, U3, U4, U5, U6: NE5532; DIP-8_W7.62mm_Socket
U7, U8, U14, U15, U18: TL072; DIP-8_W7.62mm_Socket
U9: 4052; DIP-16_W7.62mm_Socket
U17: MC1496; DIP-14_W7.62mm_Socket
U19: CD4046; DIP-16_W7.62mm_Socket
U20: CD4069; DIP-14_W7.62mm_Socket
U21: CD4013; DIP-14_W7.62mm_Socket

Connections:
+9V: C4.1, C7.2, C9.2, C13.2, C15.2, C18.2, C21.2, C27.2, C29.2, C31.2, C32.2, C35.2, C58.1, C60.1, C61.1, D2.1 (K), J4.1, J6.1, R20.2, R21.2, R22.2, SW1.3 (C), TP_+9V1.1 (1_1), U1.8 (V+), U2.8 (V+), U3.8 (V+), U4.8 (V+), U5.8 (V+), U6.8 (V+), U7.8 (V+), U8.8 (V+), U9.16 (VDD), U14.8 (V+), U15.8 (V+), U18.8 (V+), U19.16 (VDD), U20.14 (VDD), U21.14 (VDD)
-9V: C3.2, C8.2, C10.2, C14.2, C16.2, C19.1, C22.1, C28.1, C30.1, C33.1, C34.1, C36.1, C37.1, D1.2 (A), TP_-9V1.1 (1_1), U1.4 (V-), U2.4 (V-), U3.4 (V-), U4.4 (V-), U5.4 (V-), U6.4 (V-), U7.4 (V-), U8.4 (V-), U9.7 (VEE), U14.4 (V-), U15.4 (V-), U17.14 (VEE), U18.4 (V-)
/19K_BNC: C54.1, C55.1, J5.1
/19K_IN: C55.2
/38K_IN: C57.2, R27.1
/C1A: C56.1, U19.6 (C1)
/C1B: C56.2, U19.7 (C2)
/CAR_DIV: C57.1, R55.2, R56.1
/CAR_SEL: JP1.2, R55.1
/DIV19: TP34.1 (1_1), U19.3 (RefIn), U21.1 (Q)
/DIV_NQ: U21.2 (~Q), U21.5 (D)
/D_OUT: R48.1, TP9.1 (1_1), U7.5 (+), U14.7
/D_amp: R63.1, TP4.1 (1_1), U7.7, U9.5 (Y1)
/G_OUT: R53.1, TP10.1 (1_1), U8.3 (+), U15.7
/G_amp: R65.1, TP5.1 (1_1), U8.1, U9.14 (X1)
/LF_MID: C59.1, R59.2
/LOOP_PC2: R58.1, U19.13 (PC2)
/LOOP_VCO: R58.2, R59.1, U19.9 (VCOin)
/MonoTest: C23.2, R12.2, TP2.1 (1_1), U7.3 (+), U18.3 (+)
/Mono_amp: R61.1, TP3.1 (1_1), U7.1, U9.12 (X0)
/OUT_STEREO: C43.2, R24.2, U17.1 (VS+)
/PLL_SIG: C54.2, U19.14 (SigIn)
/R1_NODE: R57.1, U19.11 (R1)
/VC4+: C42.1, R26.2, U17.8 (VC+)
/VC4-: C41.1, R25.2, U17.10 (VC-)
/VCO_INV: JP1.3, U20.2
/VCO_OUT: JP1.1, TP33.1 (1_1), U19.4 (FOUT), U20.1, U21.3 (C)
/VO4+: C44.1, R20.1, U17.6 (VO+)
/VO4-: C45.1, R21.1, U17.12 (VO-)
/Vmpx: J3.4, R1.1, R2.1
/carbias: C40.1, R22.1, R23.1, R25.1, R26.1
/mpx_buf: R4.1, TP1.1 (1_1), U1.1, U1.2 (-), U6.3 (+)
/stereo_filtered: C53.2, R39.2, TP8.1 (1_1), U18.5 (+)
/stereo_unfiltered: R17.1, R31.1, TP7.1 (1_1), U6.7
GND: C2.2, C3.1, C4.2, C5.2, C7.1, C8.1, C9.1, C10.1, C11.2, C13.1, C14.1, C15.1, C16.1, C17.2, C18.1, C19.2, C21.1, C22.2, C27.1, C28.2, C29.1, C30.2, C31.1, C32.1, C33.2, C34.2, C35.1, C36.2, C37.2, C40.2, C41.2, C46.2, C47.2, C49.2, C51.2, C58.2, C59.2, C60.2, C61.2, J1.2, J2.1, J3.1, J3.3, J4.2, J4.4, J5.2, J6.2, J6.4, R1.2, R3.1, R12.1, R16.1, R18.1, R23.2, R24.1, R29.1, R39.1, R40.2, R42.2, R49.1, R56.2, R57.2, R60.2, R62.2, R64.2, SW1.1 (A), TP35.1 (1_1), TP_GND1.1 (1_1), TP_GND2.1 (1_1), U1.5 (+), U8.5 (+), U9.1 (Y0), U9.2 (Y2), U9.4 (Y3), U9.6 (Inh), U9.8 (VSS), U9.9 (B), U9.11 (X3), U9.15 (X2), U14.3 (+), U14.5 (+), U15.5 (+), U19.5 (Inh), U19.8 (VSS), U20.3, U20.5, U20.7 (VSS), U20.9, U20.11, U20.13, U21.4 (R), U21.6 (S), U21.7 (VSS), U21.8 (S), U21.9 (D), U21.10 (R), U21.11 (C)
unnamed: C1.1, R4.2, R5.1
unnamed: C6.1, R6.2, R7.1
unnamed: C12.1, R8.2, R9.1
unnamed: C20.1, R10.2, R11.1
unnamed: C38.1, R17.2, R32.1
unnamed: C42.2, R27.2
unnamed: C44.2, R28.2
unnamed: C45.2, R30.2
unnamed: C48.1, R33.2, R34.1
unnamed: C50.1, R35.2, R36.1
unnamed: C52.1, R37.2, R38.1
unnamed: D1.1 (K), J1.1
unnamed: D2.2 (A), J2.2
unnamed: J4.3, U9.13 (X)
unnamed: J6.3, U9.3 (Y)
unnamed: R44.2, R51.2, RV2.2, RV2.3, U18.1
unnamed: R45.2, R50.2, RV1.2, RV1.3, U18.7
unnamed: R46.1, R47.2, U14.1
unnamed: R52.2, R54.1, U15.1
unnamed: SW1.2 (B), U9.10 (A)
unnamed: R2.2, R3.2, U1.3 (+)
unnamed: U1.6 (-), U1.7
unnamed: C2.1, R5.2, U2.3 (+)
unnamed: C1.2, R6.1, U2.1, U2.2 (-)
unnamed: C5.1, R7.2, U2.5 (+)
unnamed: C6.2, R8.1, U2.6 (-), U2.7
unnamed: C11.1, R9.2, U3.3 (+)
unnamed: C12.2, R10.1, U3.1, U3.2 (-)
unnamed: C17.1, R11.2, U3.5 (+)
unnamed: C20.2, C23.1, U3.6 (-), U3.7
unnamed: C46.1, R32.2, U4.3 (+)
unnamed: C38.2, R33.1, U4.1, U4.2 (-)
unnamed: C47.1, R34.2, U4.5 (+)
unnamed: C48.2, R35.1, U4.6 (-), U4.7
unnamed: C49.1, R36.2, U5.3 (+)
unnamed: C50.2, R37.1, U5.1, U5.2 (-)
unnamed: C51.1, R38.2, U5.5 (+)
unnamed: C52.2, C53.1, U5.6 (-), U5.7
unnamed: C43.1, U6.1, U6.2 (-)
unnamed: R28.1, R29.2, U6.5 (+)
unnamed: R30.1, R31.2, U6.6 (-)
unnamed: R60.1, R61.2, U7.2 (-)
unnamed: R62.1, R63.2, U7.6 (-)
unnamed: R64.1, R65.2, U8.2 (-)
unnamed: U8.6 (-), U8.7
unnamed: R44.1, R45.1, R46.2, U14.2 (-)
unnamed: R47.1, R48.2, U14.6 (-)
unnamed: R49.2, R50.1, U15.3 (+)
unnamed: R51.1, R54.2, U15.2 (-)
unnamed: R52.1, R53.2, U15.6 (-)
unnamed: R16.2, U17.5 (Bias)
unnamed: R19.2, U17.2 (GAIN2)
unnamed: R19.1, U17.3 (GAIN3)
unnamed: R18.2, U17.4 (VS-)
unnamed: R40.1, RV2.1, U18.2 (-)
unnamed: R42.1, RV1.1, U18.6 (-)

Notes on the sheet:
MPX INPUT BUFFER + L+R LOW PASS (15 kHz)
L-R DEMODULATOR (MC1496)
19 kHz PILOT PLL / 38 kHz CARRIER
L-R LOW PASS (15 kHz)
LEVEL TRIM + STEREO MATRIX
OUTPUT AMPLIFIERS
MONO / STEREO OUTPUT SELECT
POWER INPUT + DECOUPLING
Power input, reverse polarity diodes
Op amp supplies, 100n per rail per package
Unused op amp halves, tied off

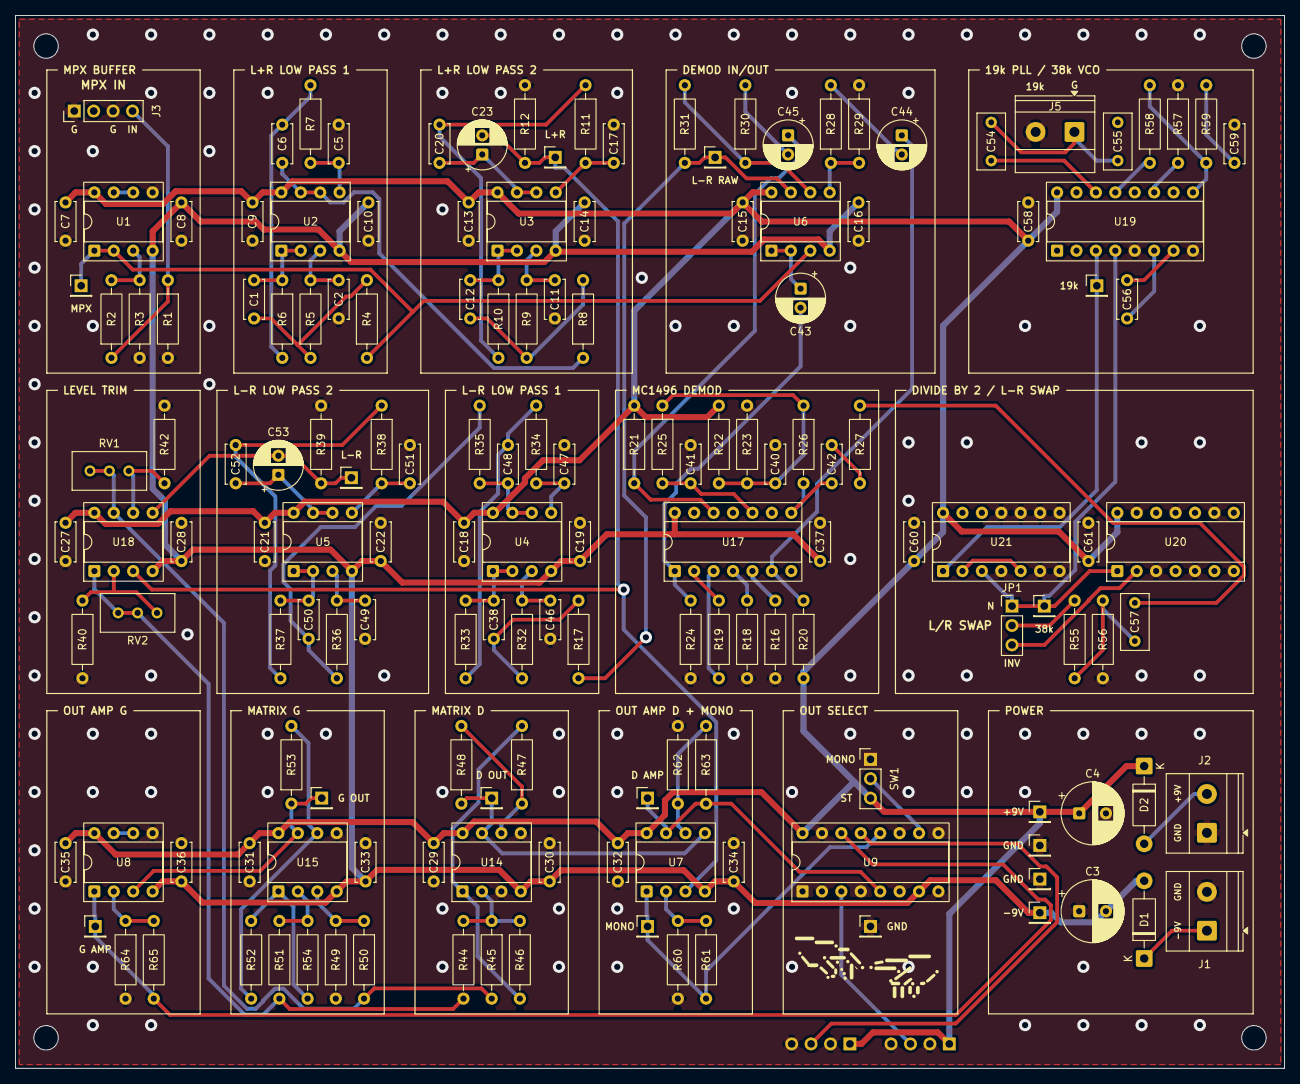
[picture p9: board Receiver.kicad_pcb from above]

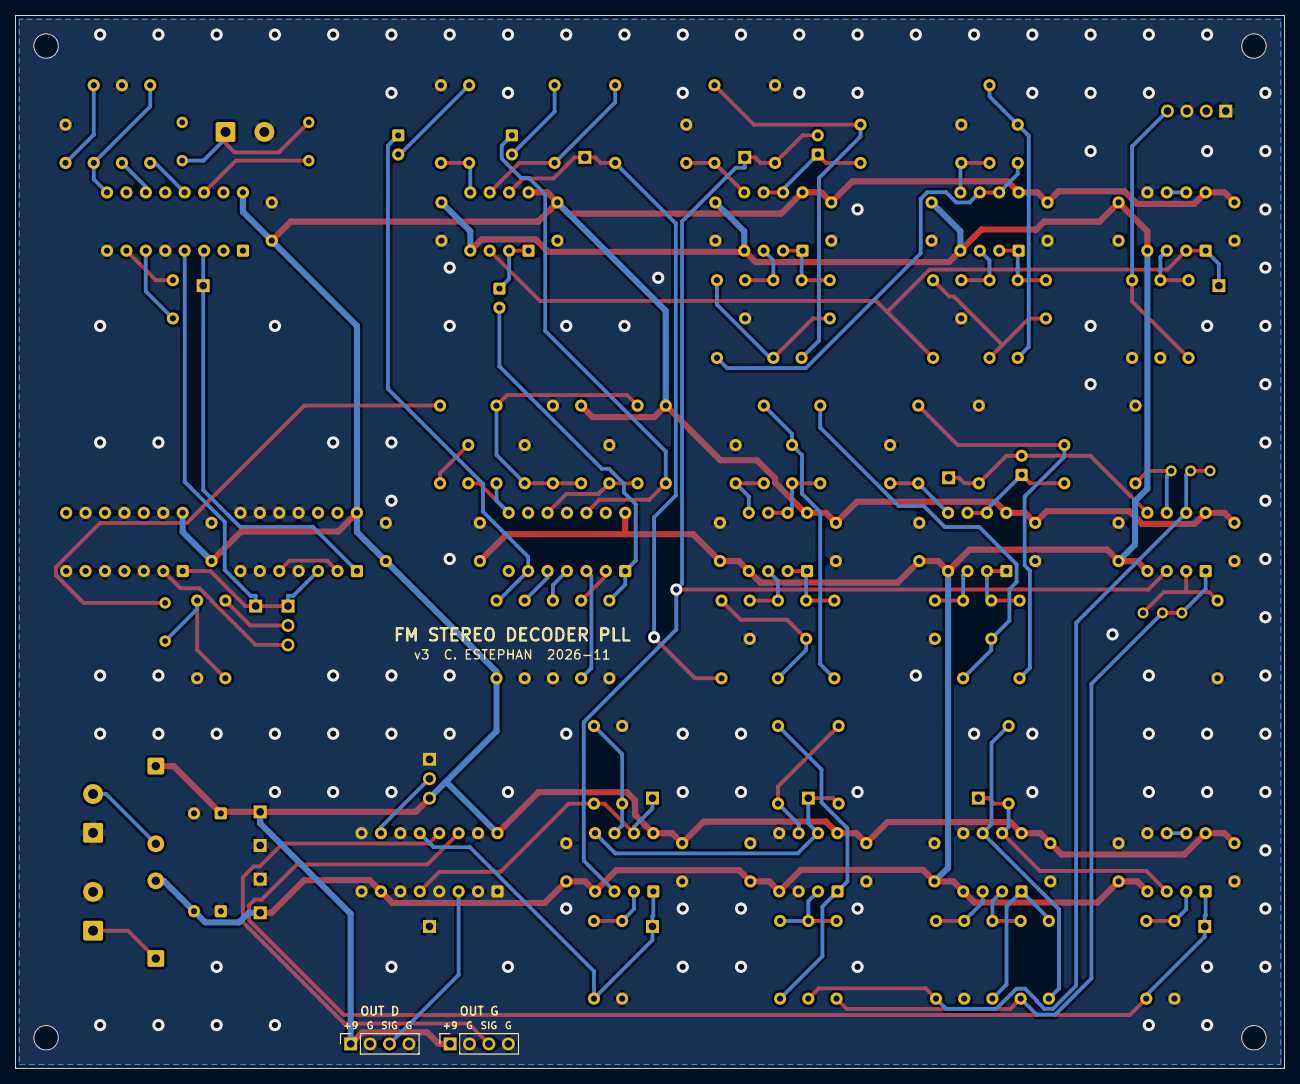
[picture p10: board Receiver.kicad_pcb from below]

Board: 2 copper layers, 166.0 x 137.7 mm, 161 parts (2 on the bottom side), 90 nets.
