charbel-j-estephan/Fm_Stereo_Encoder_Decoder/Encoder/Encoder.kicad_pcb

## KiCad design Encoder/Encoder.kicad_pcb (2026-11-05)

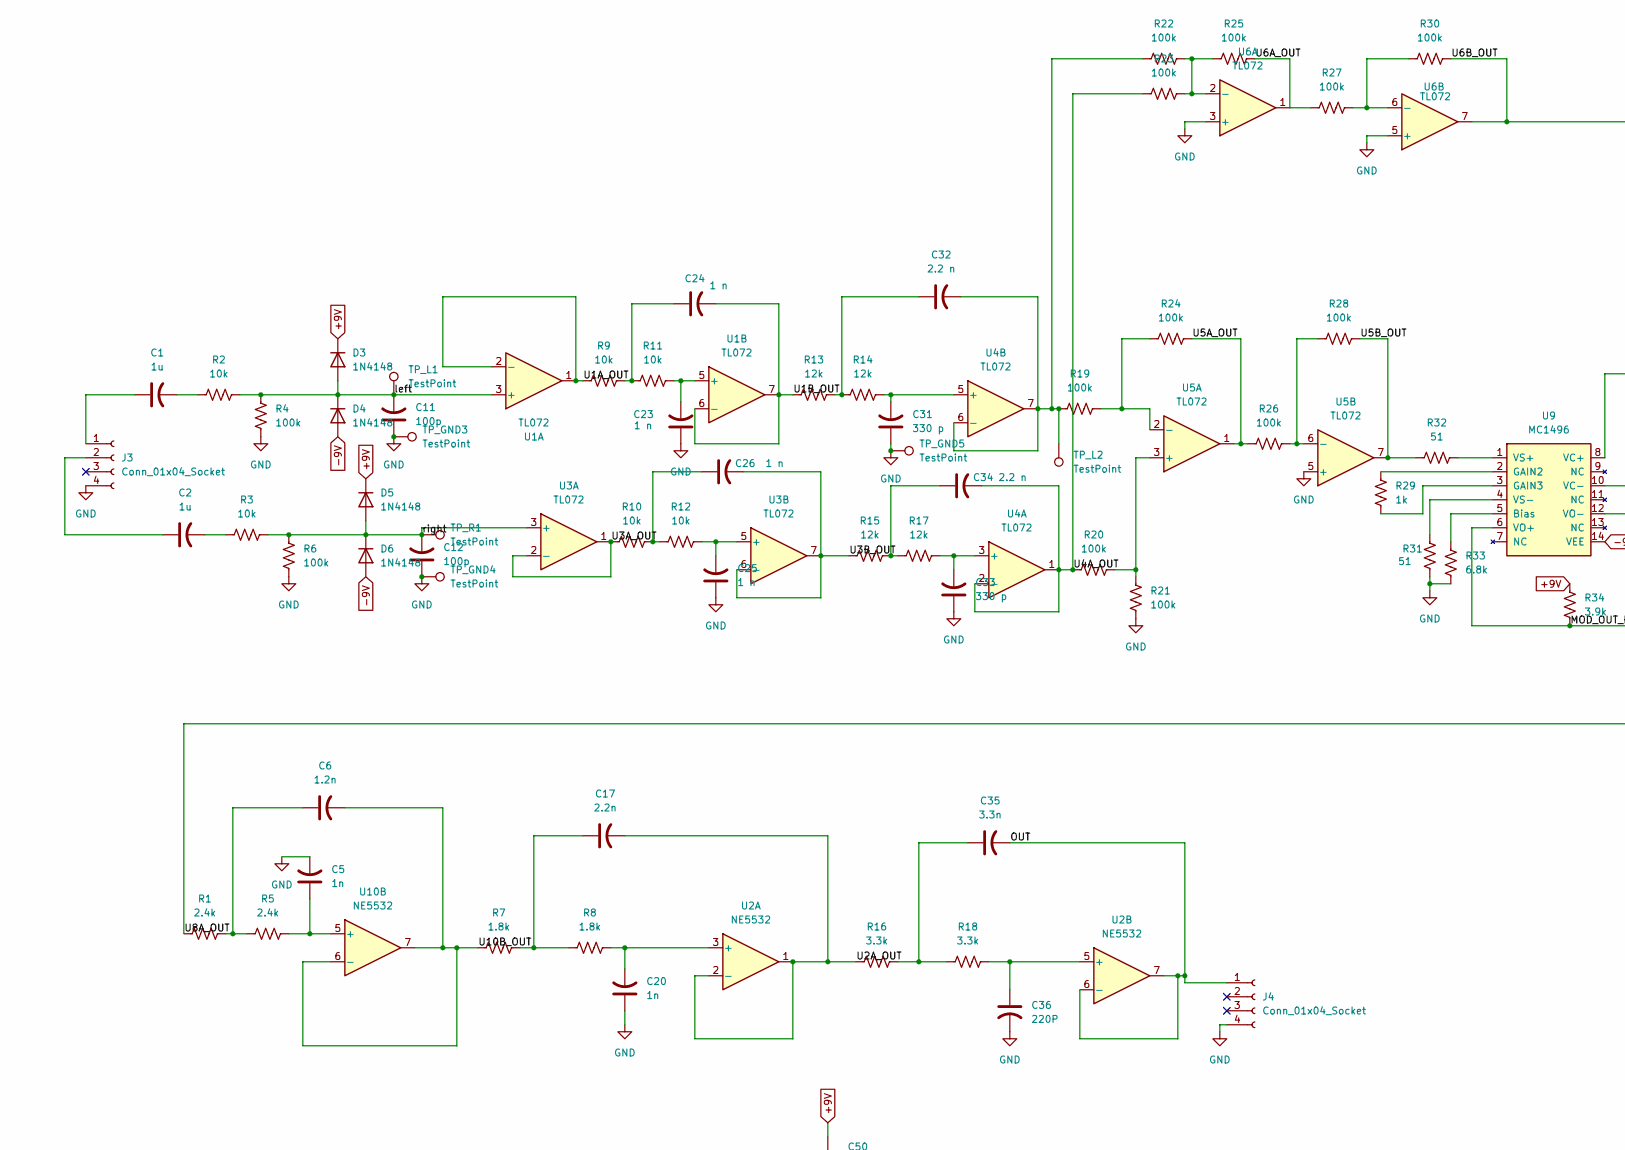
[picture p11: schematic Encoder.kicad_sch, FM Stereo Encoder, part in row 1, column 1]

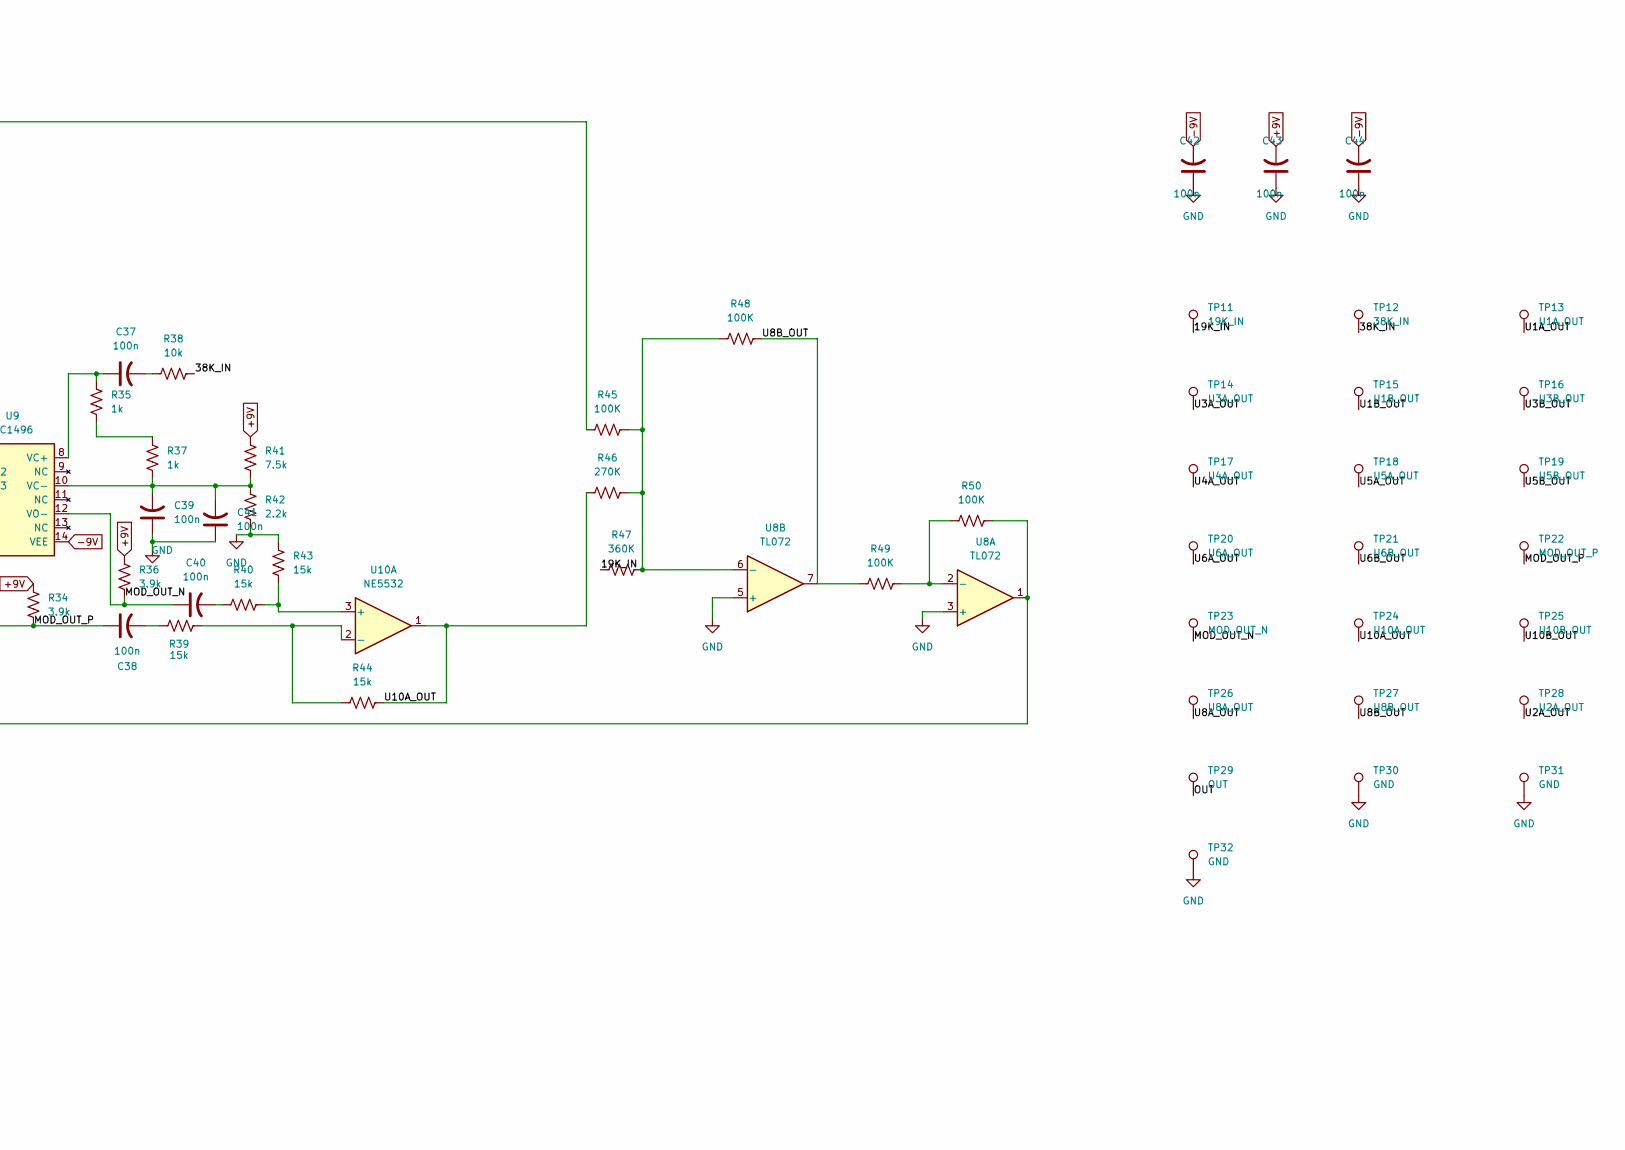
[picture p12: schematic Encoder.kicad_sch, FM Stereo Encoder, part in row 1, column 2]

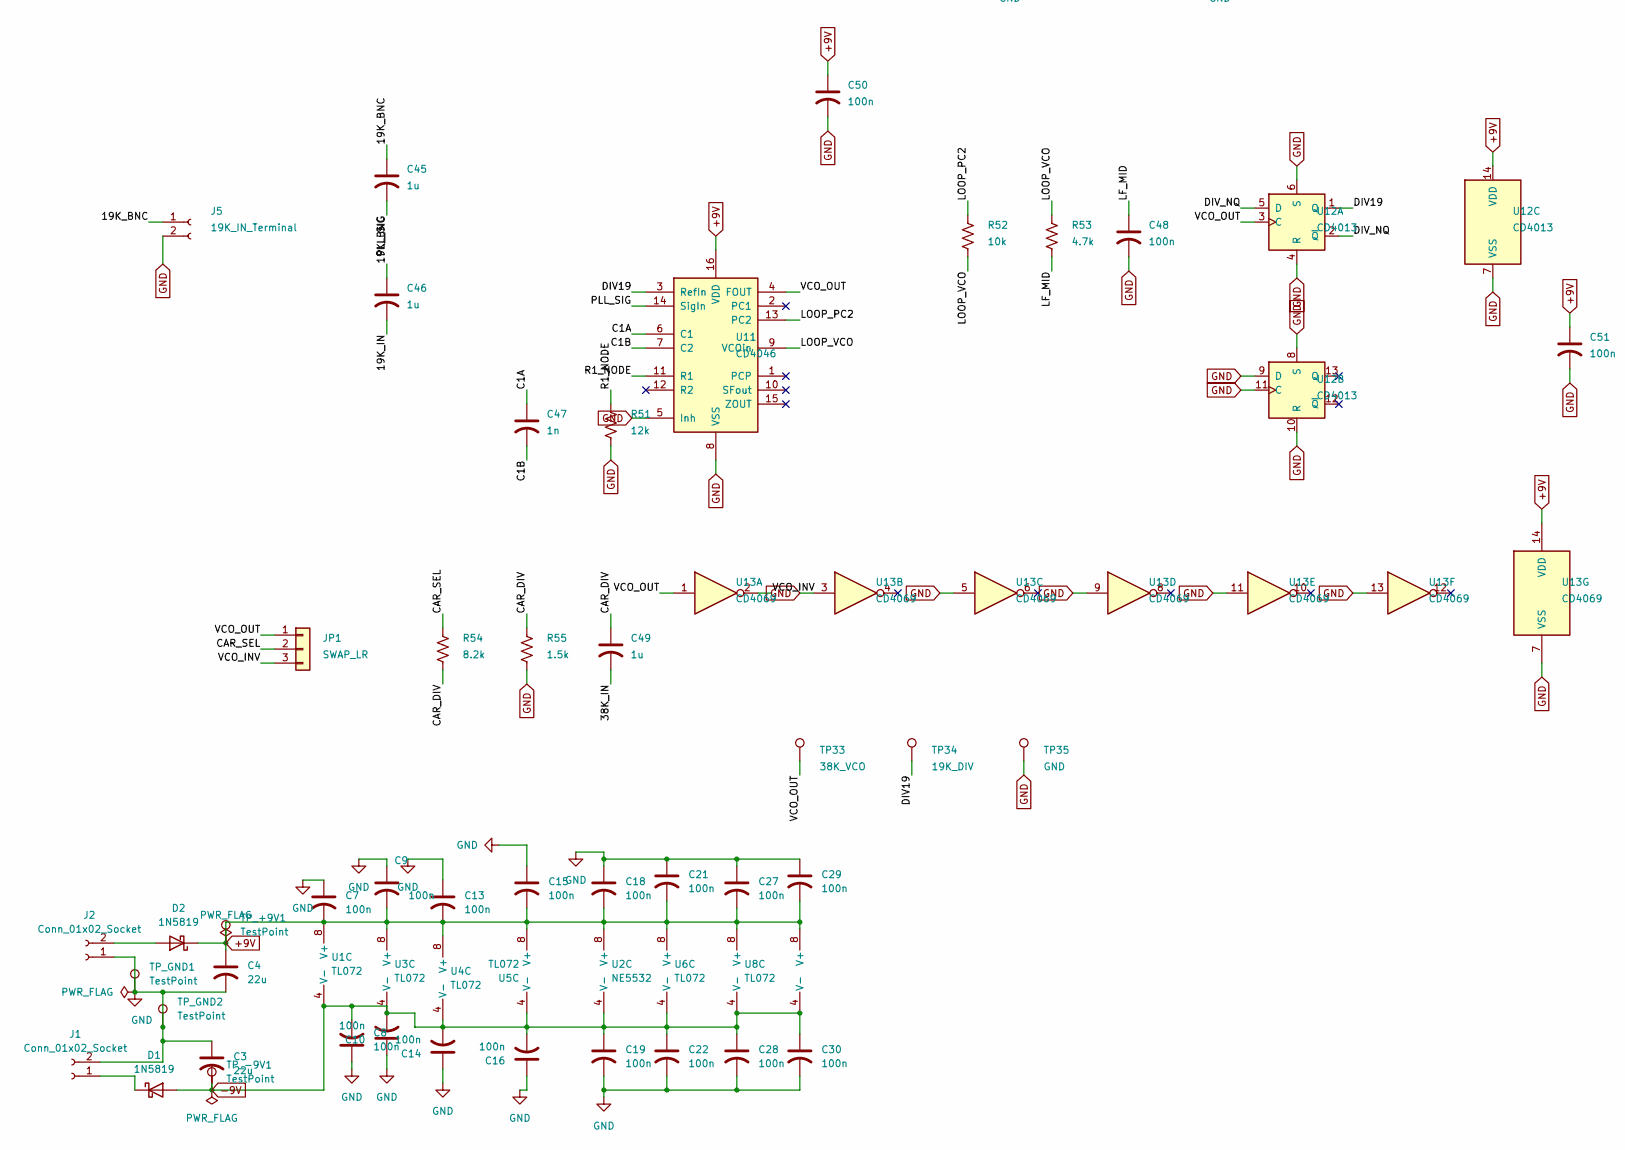
[picture p13: schematic Encoder.kicad_sch, FM Stereo Encoder, part in row 2, column 1]

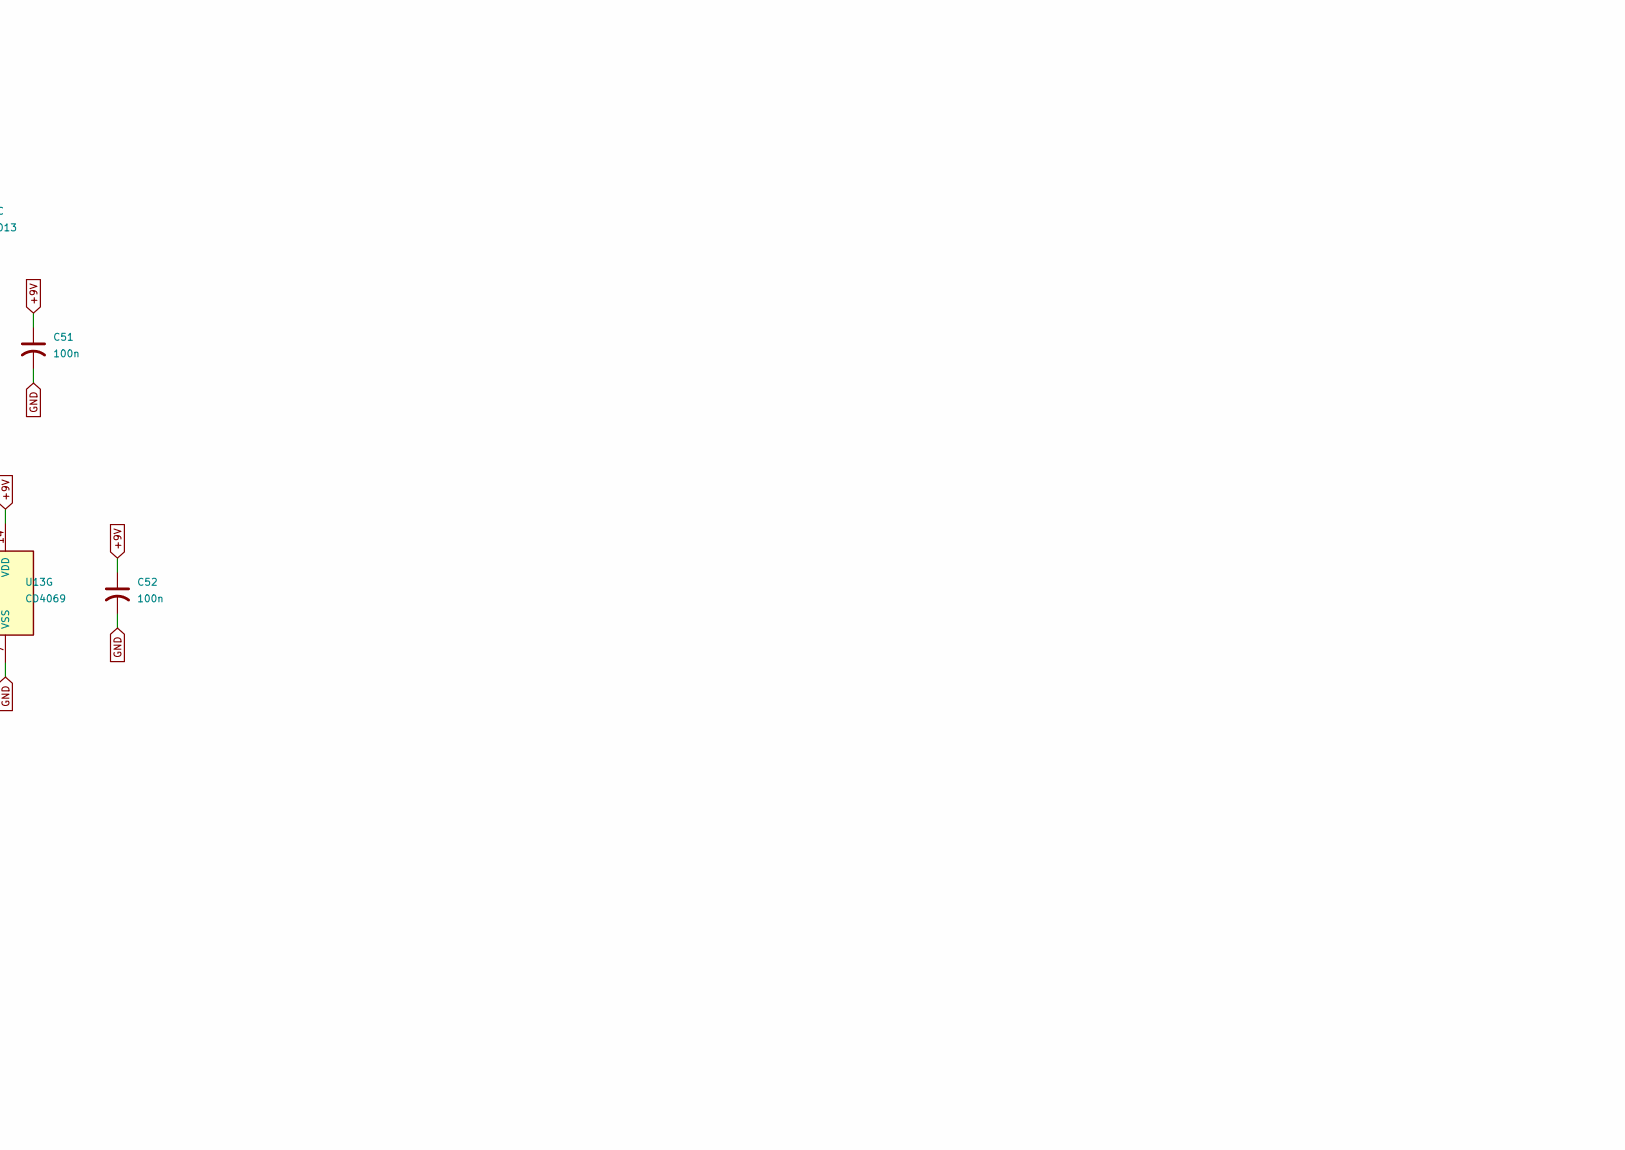
[picture p14: schematic Encoder.kicad_sch, FM Stereo Encoder, part in row 2, column 2]

Parts:
C1, C2, C45, C46, C49: 1u; C_Rect_L7.2mm_W3.5mm_P5.00mm
C3, C4: 22u; CP_Radial_D8.0mm_P3.50mm
C5, C20, C47: 1n; C_Disc_D5.0mm_W2.5mm_P5.00mm
C6: 1.2n; C_Disc_D5.0mm_W2.5mm_P5.00mm
C7, C8, C9, C10, C13, C14, C15, C16, C18, C19, C21, C22, C27, C28, C29, C30, C37, C38, C39, C40, C41, C42, C43, C44, C48, C50, C51, C52: 100n; C_Disc_D5.0mm_W2.5mm_P5.00mm
C11, C12: 100p; C_Disc_D3.0mm_W2.0mm_P2.50mm
C17: 2.2n; C_Disc_D5.0mm_W2.5mm_P5.00mm
C23, C24, C25, C26: 1 n; C_Disc_D5.0mm_W2.5mm_P5.00mm
C31, C33: 330 p; C_Disc_D5.0mm_W2.5mm_P5.00mm
C32, C34: 2.2 n; C_Disc_D5.0mm_W2.5mm_P5.00mm
C35: 3.3n; C_Disc_D5.0mm_W2.5mm_P5.00mm
C36: 220P; C_Disc_D5.0mm_W2.5mm_P5.00mm
D1, D2: 1N5819; D_DO-41_SOD81_P10.16mm_Horizontal
D3, D4, D5, D6: 1N4148; D_DO-35_SOD27_P7.62mm_Horizontal
J1, J2: Conn_01x02_Socket; TerminalBlock_Phoenix_MKDS-1,5-2-5.08_1x02_P5.08mm_Horizont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
J3, J4: Conn_01x04_Socket; PinSocket_1x04_P2.54mm_Vertical
J5: 19K_IN_Terminal; TerminalBlock_Phoenix_MKDS-1,5-2-5.08_1x02_P5.08mm_Horizont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
JP1: SWAP_LR; PinHeader_1x03_P2.54mm_Vertical
R1, R5: 2.4k; R_Axial_DIN0207_L6.3mm_D2.5mm_P10.16mm_Horizontal
R2, R3, R9, R10, R11, R12, R38, R52: 10k; R_Axial_DIN0207_L6.3mm_D2.5mm_P10.16mm_Horizontal
R4, R6, R19, R20, R21, R22, R23, R24, R25, R26, R27, R28, R30: 100k; R_Axial_DIN0207_L6.3mm_D2.5mm_P10.16mm_Horizontal
R7, R8: 1.8k; R_Axial_DIN0207_L6.3mm_D2.5mm_P10.16mm_Horizontal
R13, R14, R15, R17, R51: 12k; R_Axial_DIN0207_L6.3mm_D2.5mm_P10.16mm_Horizontal
R16, R18: 3.3k; R_Axial_DIN0207_L6.3mm_D2.5mm_P10.16mm_Horizontal
R29, R35, R37: 1k; R_Axial_DIN0207_L6.3mm_D2.5mm_P10.16mm_Horizontal
R31, R32: 51; R_Axial_DIN0207_L6.3mm_D2.5mm_P10.16mm_Horizontal
R33: 6.8k; R_Axial_DIN0207_L6.3mm_D2.5mm_P10.16mm_Horizontal
R34, R36: 3.9k; R_Axial_DIN0207_L6.3mm_D2.5mm_P10.16mm_Horizontal
R39, R40, R43, R44: 15k; R_Axial_DIN0207_L6.3mm_D2.5mm_P10.16mm_Horizontal
R41: 7.5k; R_Axial_DIN0207_L6.3mm_D2.5mm_P10.16mm_Horizontal
R42: 2.2k; R_Axial_DIN0207_L6.3mm_D2.5mm_P10.16mm_Horizontal
R45, R48, R49, R50: 100K; R_Axial_DIN0207_L6.3mm_D2.5mm_P10.16mm_Horizontal
R46: 270K; R_Axial_DIN0207_L6.3mm_D2.5mm_P10.16mm_Horizontal
R47: 360K; R_Axial_DIN0207_L6.3mm_D2.5mm_P10.16mm_Horizontal
R53: 4.7k; R_Axial_DIN0207_L6.3mm_D2.5mm_P10.16mm_Horizontal
R54: 8.2k; R_Axial_DIN0207_L6.3mm_D2.5mm_P10.16mm_Horizontal
R55: 1.5k; R_Axial_DIN0207_L6.3mm_D2.5mm_P10.16mm_Horizontal
TP11: 19K_IN; PinHeader_1x01_P2.54mm_Vertical
TP12: 38K_IN; PinHeader_1x01_P2.54mm_Vertical
TP13: U1A_OUT; PinHeader_1x01_P2.54mm_Vertical
TP14: U3A_OUT; PinHeader_1x01_P2.54mm_Vertical
TP15: U1B_OUT; PinHeader_1x01_P2.54mm_Vertical
TP16: U3B_OUT; PinHeader_1x01_P2.54mm_Vertical
TP17: U4A_OUT; PinHeader_1x01_P2.54mm_Vertical
TP18: U5A_OUT; PinHeader_1x01_P2.54mm_Vertical
TP19: U5B_OUT; PinHeader_1x01_P2.54mm_Vertical
TP20: U6A_OUT; PinHeader_1x01_P2.54mm_Vertical
TP21: U6B_OUT; PinHeader_1x01_P2.54mm_Vertical
TP22: MOD_OUT_P; PinHeader_1x01_P2.54mm_Vertical
TP23: MOD_OUT_N; PinHeader_1x01_P2.54mm_Vertical
TP24: U10A_OUT; PinHeader_1x01_P2.54mm_Vertical
TP25: U10B_OUT; PinHeader_1x01_P2.54mm_Vertical
TP26: U8A_OUT; PinHeader_1x01_P2.54mm_Vertical
TP27: U8B_OUT; PinHeader_1x01_P2.54mm_Vertical
TP28: U2A_OUT; PinHeader_1x01_P2.54mm_Vertical
TP29: OUT; PinHeader_1x01_P2.54mm_Vertical
TP30, TP31, TP32, TP35: GND; PinHeader_1x01_P2.54mm_Vertical
TP33: 38K_VCO; PinHeader_1x01_P2.54mm_Vertical
TP34: 19K_DIV; PinHeader_1x01_P2.54mm_Vertical
TP_+9V1: TestPoint; PinHeader_1x01_P2.54mm_Vertical
TP_-9V1: TestPoint; PinHeader_1x01_P2.54mm_Vertical
TP_GND1, TP_GND2, TP_GND3, TP_GND4, TP_GND5: TestPoint; PinHeader_1x01_P2.54mm_Vertical
TP_L1, TP_L2: TestPoint; PinHeader_1x01_P2.54mm_Vertical
TP_R1: TestPoint; PinHeader_1x01_P2.54mm_Vertical
U1, U3, U4, U5, U6, U8: TL072; DIP-8_W7.62mm_Socket
U2, U10: NE5532; DIP-8_W7.62mm_Socket
U9: MC1496; DIP-14_W7.62mm_Socket
U11: CD4046; DIP-16_W7.62mm_Socket
U12: CD4013; DIP-14_W7.62mm_Socket
U13: CD4069; DIP-14_W7.62mm_Socket

Connections:
+9V: C4.1, C7.2, C9.2, C13.2, C15.2, C18.2, C21.2, C27.2, C29.2, C43.2, C50.1, C51.1, C52.1, D2.1 (K), D3.1 (K), D5.1 (K), R34.1, R36.1, R41.1, TP_+9V1.1, U1.8 (V+), U2.8 (V+), U3.8 (V+), U4.8 (V+), U5.8 (V+), U6.8 (V+), U8.8 (V+), U10.8 (V+), U11.16 (VDD), U12.14 (VDD), U13.14 (VDD)
-9V: C3.2, C8.2, C10.2, C14.2, C16.2, C19.1, C22.1, C28.1, C30.1, C42.2, C44.2, D1.2 (A), D4.2 (A), D6.2 (A), TP_-9V1.1, U1.4 (V-), U2.4 (V-), U3.4 (V-), U4.4 (V-), U5.4 (V-), U6.4 (V-), U8.4 (V-), U9.14 (VEE), U10.4 (V-)
/19K_BNC: C45.1, C46.1, J5.1
/19K_IN: C46.2, R47.1, TP11.1
/38K_IN: C49.2, R38.2, TP12.1
/C1A: C47.1, U11.6 (C1)
/C1B: C47.2, U11.7 (C2)
/CAR_DIV: C49.1, R54.2, R55.1
/CAR_SEL: JP1.2, R54.1
/DIV19: TP34.1, U11.3 (RefIn), U12.1 (Q)
/DIV_NQ: U12.2 (~Q), U12.5 (D)
/LF_MID: C48.1, R53.2
/LOOP_PC2: R52.1, U11.13 (PC2)
/LOOP_VCO: R52.2, R53.1, U11.9 (VCOin)
/MOD_OUT_N: C40.1, R36.2, TP23.1, U9.12 (VO-)
/MOD_OUT_P: C38.1, R34.2, TP22.1, U9.6 (VO+)
/OUT: C35.2, J4.1, TP29.1, U2.6 (-), U2.7
/PLL_SIG: C45.2, U11.14 (SigIn)
/R1_NODE: R51.1, U11.11 (R1)
/U1A_OUT: R9.1, TP13.1, U1.1, U1.2 (-)
/U1B_OUT: C24.2, R13.1, TP15.1, U1.6 (-), U1.7
/U2A_OUT: C17.2, R16.1, TP28.1, U2.1, U2.2 (-)
/U3A_OUT: R10.1, TP14.1, U3.1, U3.2 (-)
/U3B_OUT: C26.2, R15.1, TP16.1, U3.6 (-), U3.7
/U4A_OUT: C34.2, R20.1, R23.1, TP17.1, U4.1, U4.2 (-)
/U5A_OUT: R24.2, R26.1, TP18.1, U5.1
/U5B_OUT: R28.2, R32.1, TP19.1, U5.7
/U6A_OUT: R25.2, R27.1, TP20.1, U6.1
/U6B_OUT: R30.2, R45.1, TP21.1, U6.7
/U8A_OUT: R1.1, R50.2, TP26.1, U8.1
/U8B_OUT: R48.2, R49.1, TP27.1, U8.7
/U10A_OUT: R44.2, R46.1, TP24.1, U10.1
/U10B_OUT: C6.2, R7.1, TP25.1, U10.6 (-), U10.7
/VCO_INV: JP1.3, U13.2
/VCO_OUT: JP1.1, TP33.1, U11.4 (FOUT), U12.3 (C), U13.1
/left: C11.2, D3.2 (A), D4.1 (K), R2.2, R4.1, TP_L1.1, U1.3 (+)
/right: C12.2, D5.2 (A), D6.1 (K), R3.2, R6.1, TP_R1.1, U3.3 (+)
GND: C3.1, C4.2, C5.2, C7.1, C8.1, C9.1, C10.1, C11.1, C12.1, C13.1, C14.1, C15.1, C16.1, C18.1, C19.2, C20.1, C21.1, C22.2, C23.1, C25.1, C27.1, C28.2, C29.1, C30.2, C31.1, C33.1, C36.2, C39.1, C41.1, C42.1, C43.1, C44.1, C48.2, C50.2, C51.2, C52.2, J1.2, J2.1, J3.4, J4.4, J5.2, R4.2, R6.2, R21.2, R31.2, R33.2, R42.2, R43.1, R51.2, R55.2, TP30.1, TP31.1, TP32.1, TP35.1, TP_GND1.1, TP_GND2.1, TP_GND3.1, TP_GND4.1, TP_GND5.1, U5.5 (+), U6.3 (+), U6.5 (+), U8.3 (+), U8.5 (+), U11.5 (Inh), U11.8 (VSS), U12.4 (R), U12.6 (S), U12.7 (VSS), U12.8 (S), U12.9 (D), U12.10 (R), U12.11 (C), U13.3, U13.5, U13.7 (VSS), U13.9, U13.11, U13.13
unnamed: C1.2, R2.1
unnamed: C2.2, R3.1
unnamed: C6.1, R1.2, R5.1
unnamed: C17.1, R7.2, R8.1
unnamed: C24.1, R9.2, R11.1
unnamed: C26.1, R10.2, R12.1
unnamed: C32.1, R13.2, R14.1
unnamed: C34.1, R15.2, R17.1
unnamed: C35.1, R16.2, R18.1
unnamed: C37.2, R38.1
unnamed: C38.2, R39.2
unnamed: C40.2, R40.1
unnamed: D1.1 (K), J1.1
unnamed: D2.2 (A), J2.2
unnamed: C1.1, J3.1
unnamed: C2.1, J3.2
unnamed: R35.2, R37.1
unnamed: C23.2, R11.2, U1.5 (+)
unnamed: C20.2, R8.2, U2.3 (+)
unnamed: C36.1, R18.2, U2.5 (+)
unnamed: C25.2, R12.2, U3.5 (+)
unnamed: C33.2, R17.2, U4.3 (+)
unnamed: C31.2, R14.2, U4.5 (+)
unnamed: C32.2, R19.1, R22.1, TP_L2.1, U4.6 (-), U4.7
unnamed: R20.2, R21.1, U5.3 (+)
unnamed: R19.2, R24.1, U5.2 (-)
unnamed: R26.2, R28.1, U5.6 (-)
unnamed: R22.2, R23.2, R25.1, U6.2 (-)
unnamed: R27.2, R30.1, U6.6 (-)
unnamed: R49.2, R50.1, U8.2 (-)
unnamed: R45.2, R46.2, R47.2, R48.1, U8.6 (-)
unnamed: R33.1, U9.5 (Bias)
unnamed: R29.1, U9.2 (GAIN2)
unnamed: R29.2, U9.3 (GAIN3)
unnamed: C37.1, R35.1, U9.8 (VC+)
unnamed: C39.2, C41.2, R37.2, R41.2, R42.1, U9.10 (VC-)
unnamed: R32.2, U9.1 (VS+)
unnamed: R31.1, U9.4 (VS-)
unnamed: R40.2, R43.2, U10.3 (+)
unnamed: R39.1, R44.1, U10.2 (-)
unnamed: C5.1, R5.2, U10.5 (+)

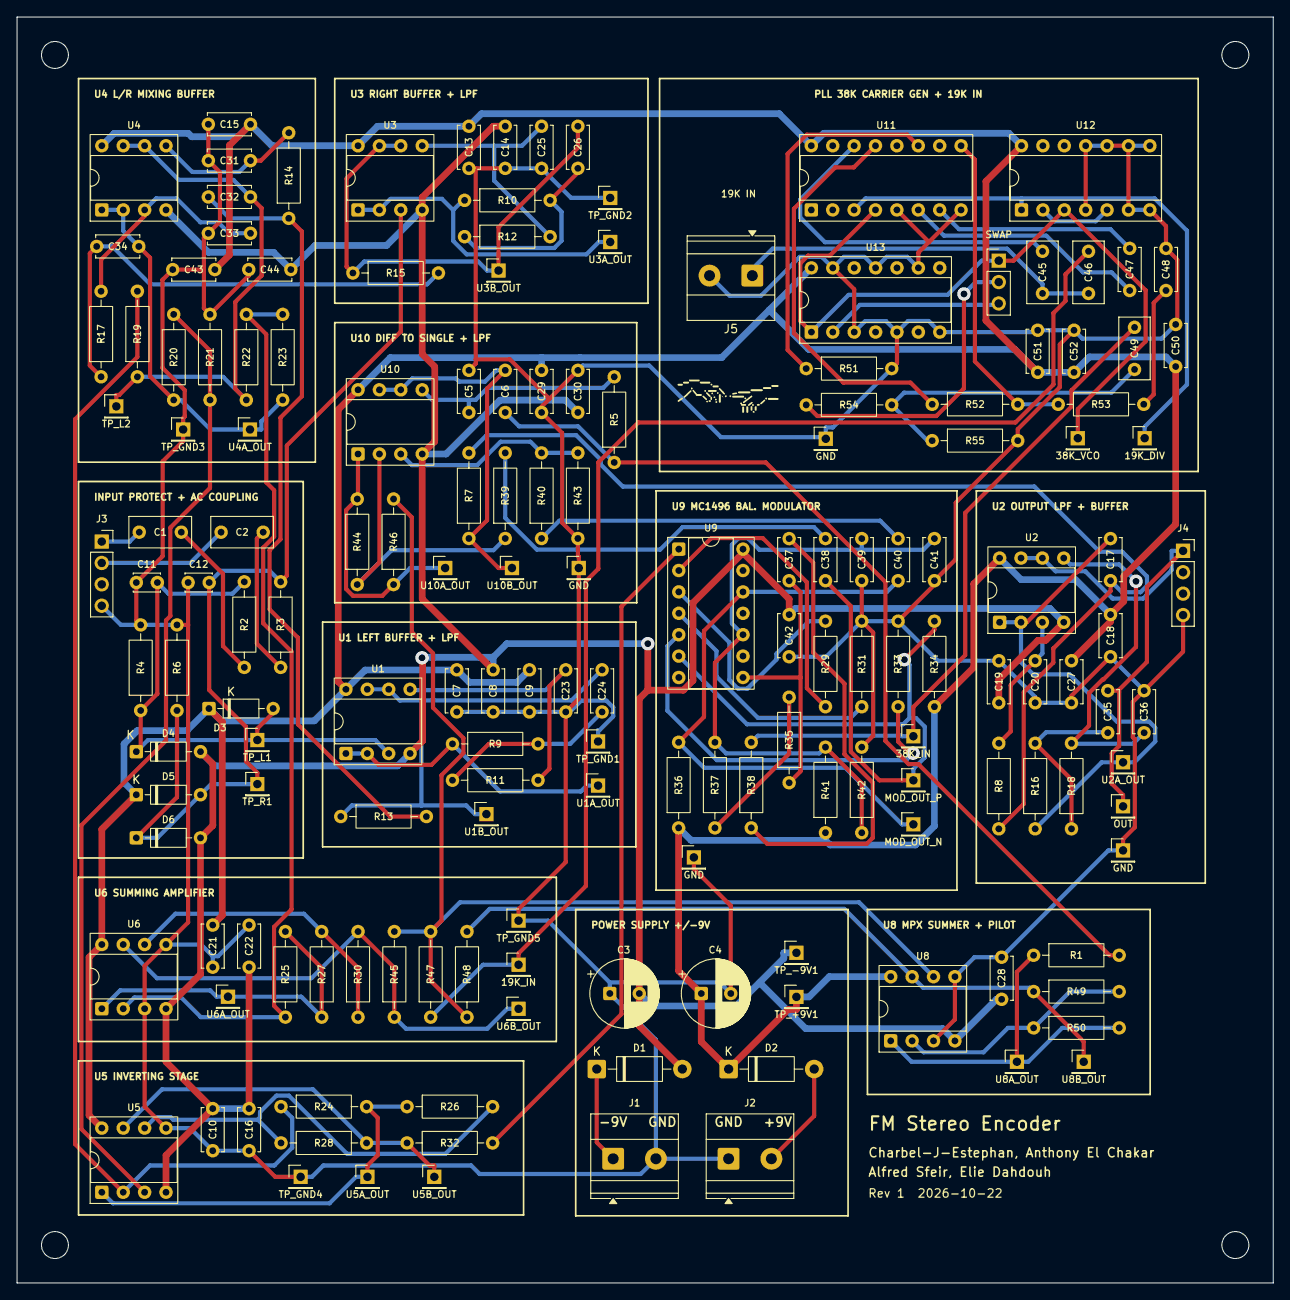
[picture p15: board Encoder.kicad_pcb from above]

Board: 2 copper layers, 149.1 x 150.3 mm, 170 parts (0 on the bottom side), 79 nets.

Other parts of the board:
H1, H2, H3, H4: M3; MountingHole_3.2mm_M3
