charbel-j-estephan/Fm_Stereo_Encoder_Decoder/(commit log)

2026-10-17 power supply
    [Encoder.kicad_pcb, Encoder.kicad_sch, freerouting.dsn, temp-freerouting.dsn]
2026-10-17 added the filter for L and R
    [Encoder.kicad_pcb, Encoder.kicad_sch, freerouting.dsn, temp-freerouting.dsn]
2026-10-18 schematics almost done
    [Encoder.kicad_pcb, Encoder.kicad_sch, freerouting.dsn, temp-freerouting.dsn]
2026-10-18 new board layout
    [Encoder.kicad_pcb, Encoder.kicad_sch]
2026-10-22 encoder pcb test 1 is almost done
    [Encoder.kicad_pcb, Encoder.kicad_sch, freerouting.dsn, temp-freerouting.dsn]
2026-10-22 2 versions are available right now need to test the actual footprint before starting -- the 19k and 38k are still missing
    [Encoder.kicad_pcb, Encoder.kicad_sch, Encoder_compact.kicad_pcb, Encoder_compact.kicad_sch, Encoder_final.kicad_pcb, Encoder_final.kicad_sch, temp-freerouting.dsn]
2026-10-22 encoder V1 is done need testing
    [Encoder_compact.kicad_pcb, Encoder_compact.kicad_sch, Encoder_final.kicad_pcb, Encoder_final.kicad_sch, Encoder_gen.kicad_pcb, Encoder_gen.kicad_sch, FM_Encoder_Buy_List.xlsx]
2026-11-05 Rename encoder project, add decoder, ignore KiCad history
    [Encoder.kicad_pcb, Encoder.kicad_sch, Encoder_compact.kicad_pcb, Encoder_compact.kicad_sch, Encoder_final.kicad_pcb, Encoder_final.kicad_sch, Encoder_gen.kicad_pcb, FM_Encoder_Buy_List.xlsx]
